XimbalEk-Electronica/CompVuelo/KiCad-Libraries/bordeplaca.dxf

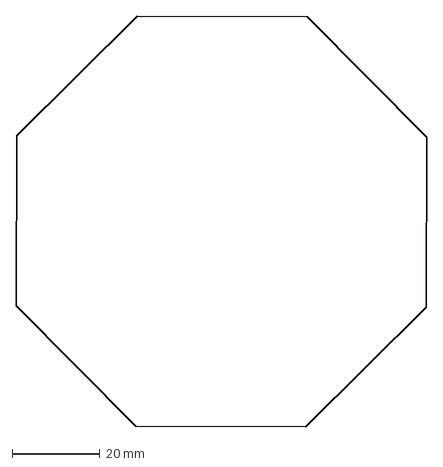
[picture p1: CAD file, 2025-10-03]
KiCad-Libraries/bordeplaca.dxf
93.3 x 93.3 mm
