XimbalEk-Electronica/CompVuelo/KiCad-Libraries/CompVuelo_3D/LCC-18_9P7X10P1_STM.step

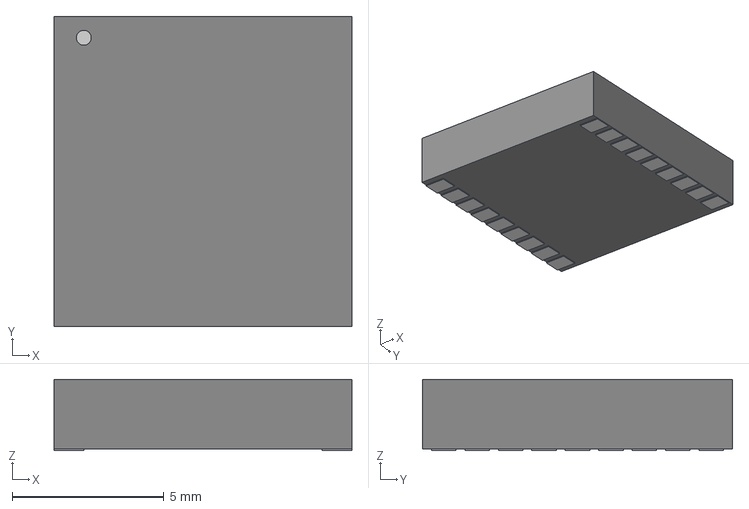
[picture p2: CAD file, 2025-10-03]
KiCad-Libraries/CompVuelo_3D/LCC-18_9P7X10P1_STM.step
9.80 x 10.2 x 2.34 mm
