XimbalEk-Electronica/CompVuelo/KiCad-Libraries/CompVuelo_3D/ESP32-S3-MINI-1U-N8--3DModel-STEP-56544.STEP

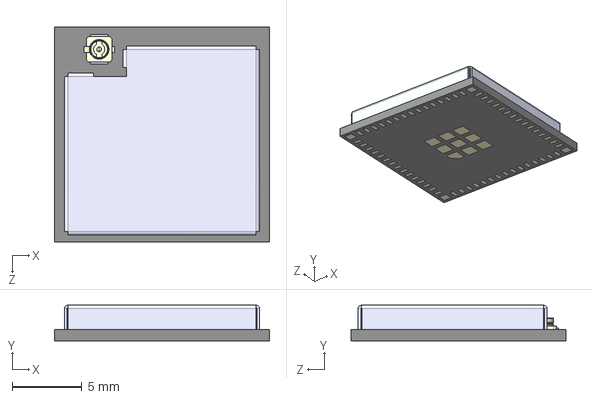
[picture p3: CAD file, 2025-10-03]
KiCad-Libraries/CompVuelo_3D/ESP32-S3-MINI-1U-N8--3DModel-STEP-56544.STEP
15.4 x 2.55 x 15.4 mm
ESP32-S3-MINI-1U-N8_ESP32-C3-MINI-1-N4
antenna jack
