XimbalEk-Electronica/CompVuelo/KiCad-Libraries/CompVuelo_3D/E22-400M22S.STEP

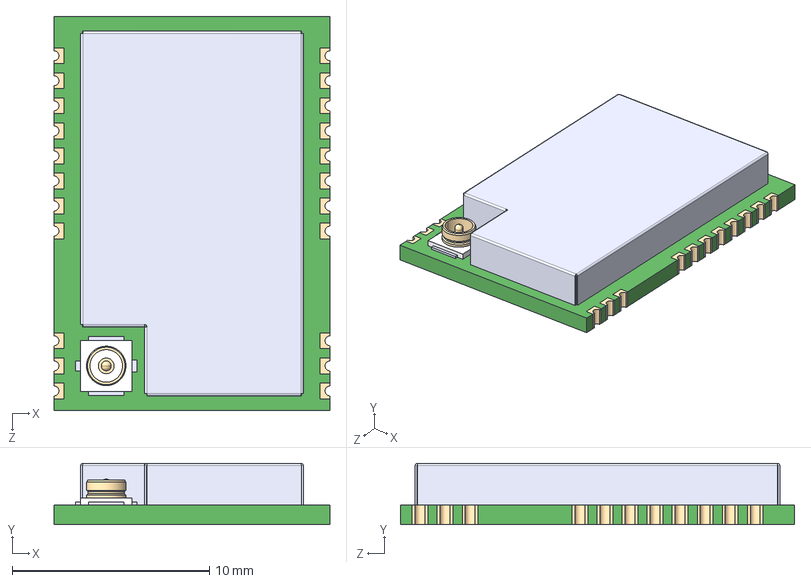
[picture p4: CAD file, 2025-10-03]
KiCad-Libraries/CompVuelo_3D/E22-400M22S.STEP
14.0 x 3.10 x 20.0 mm
