XimbalEk-Electronica/CompVuelo/KiCad-Libraries/CompVuelo_3D/LIS2MDLTR.step

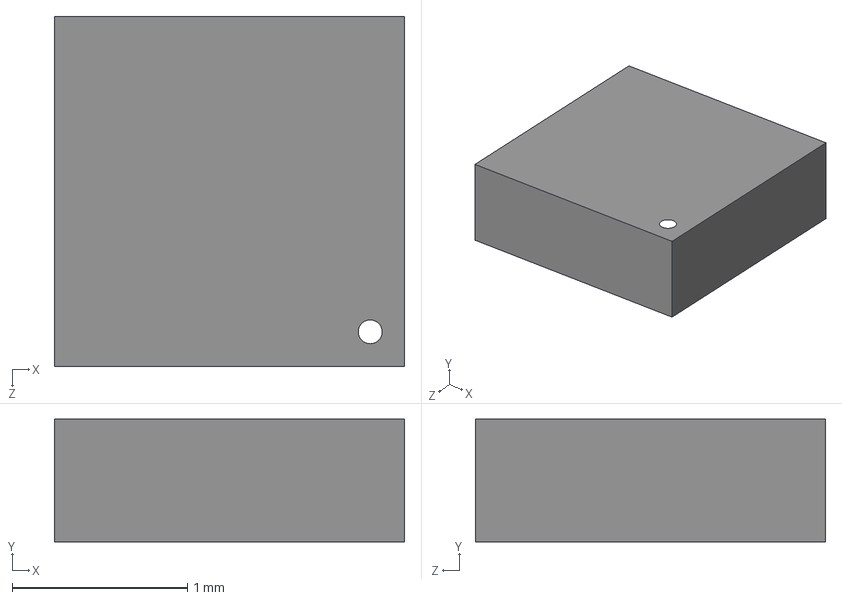
[picture p5: CAD file, 2025-10-03]
KiCad-Libraries/CompVuelo_3D/LIS2MDLTR.step
2.00 x 0.7 x 2.00 mm
