XimbalEk-Electronica/CompVuelo/KiCad-Libraries/CompVuelo_3D/XT60-M.step

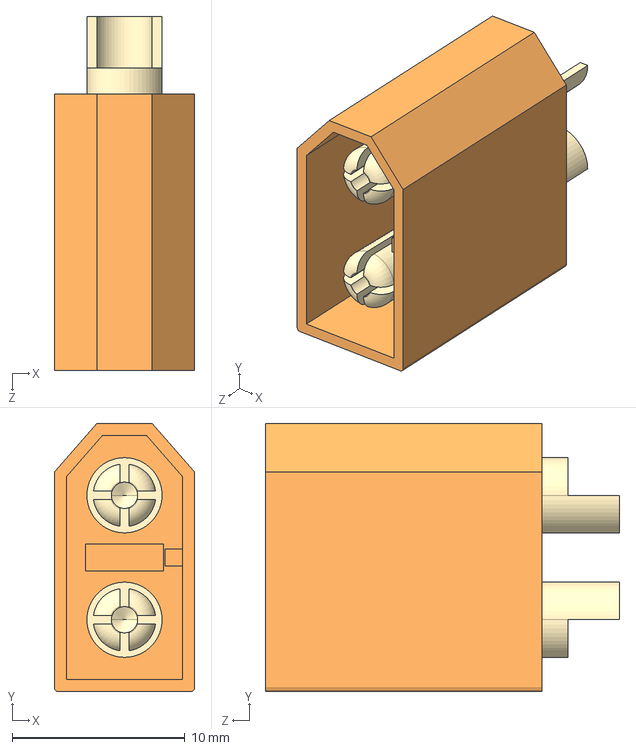
[picture p6: CAD file, 2025-10-03]
KiCad-Libraries/CompVuelo_3D/XT60-M.step
8.10 x 15.5 x 20.5 mm
