XimbalEk-Electronica/CompVuelo/KiCad-Libraries/CompVuelo_3D/BMP390L.step

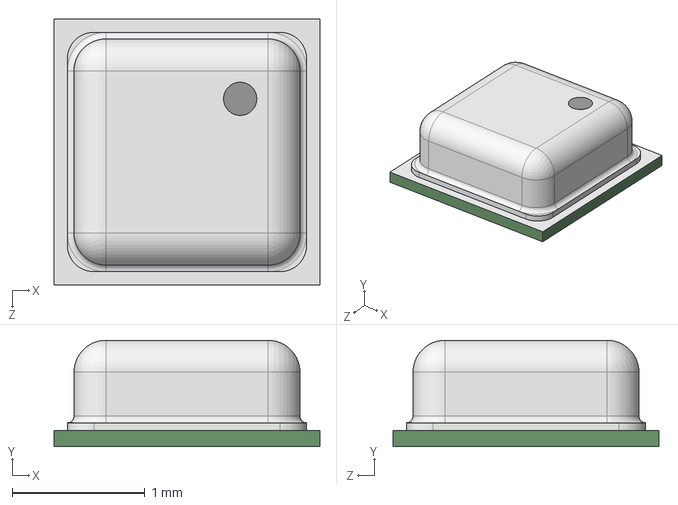
[picture p7: CAD file, 2025-09-26]
KiCad-Libraries/CompVuelo_3D/BMP390L.step
2.00 x 0.8 x 2.00 mm
