XimbalEk-Electronica/CompVuelo/KiCad-Libraries/CompVuelo_3D/BMI270.step

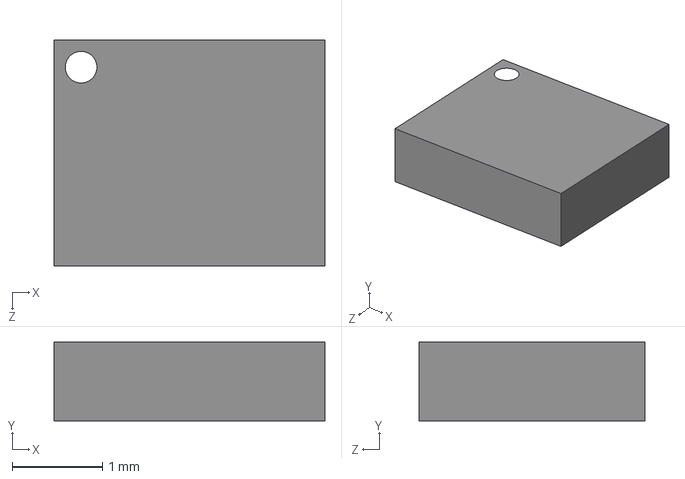
[picture p8: CAD file, 2025-09-26]
KiCad-Libraries/CompVuelo_3D/BMI270.step
3.00 x 0.87 x 2.50 mm
