XimbalEk-Electronica/CompVuelo/KiCad-Libraries/CompVuelo_3D/Pin Header 2x6 TH Pitch 2.54mm.stp

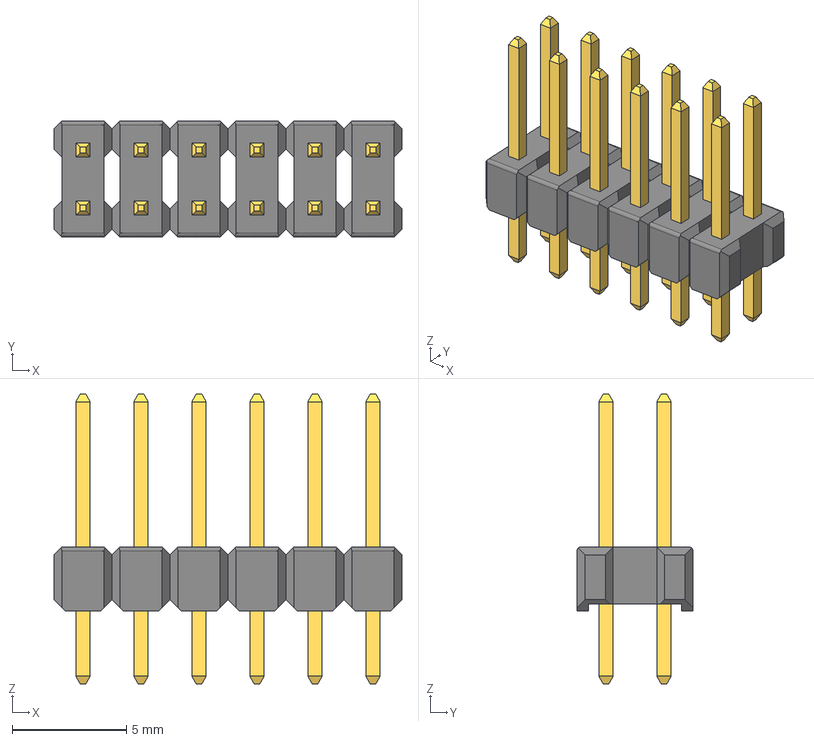
[picture p9: CAD file, 2025-09-23]
KiCad-Libraries/CompVuelo_3D/Pin Header 2x6 TH Pitch 2.54mm.stp
15.2 x 5.08 x 12.7 mm
