XimbalEk-Electronica/CompVuelo/KiCad-Libraries/CompVuelo_3D/VSSOP-8_3.0x3.0mm_P0.65mm.step

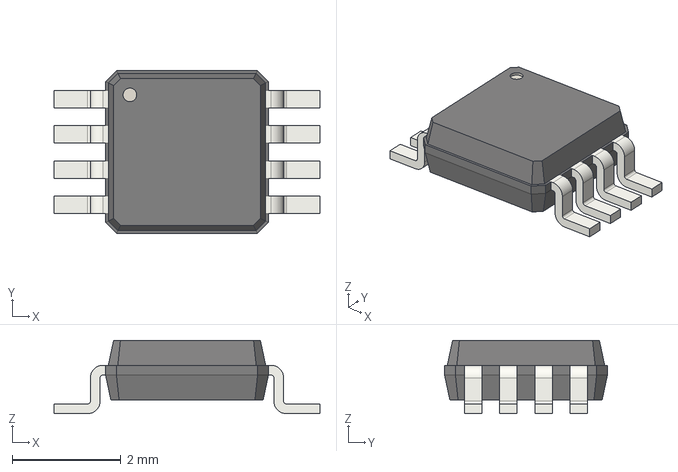
[picture p10: CAD file, 2025-09-23]
KiCad-Libraries/CompVuelo_3D/VSSOP-8_3.0x3.0mm_P0.65mm.step
4.90 x 3.00 x 1.35 mm
