XimbalEk-Electronica/CompVuelo/KiCad-Libraries/CompVuelo_3D/L-KLS7-SS-12F20A-G5.step

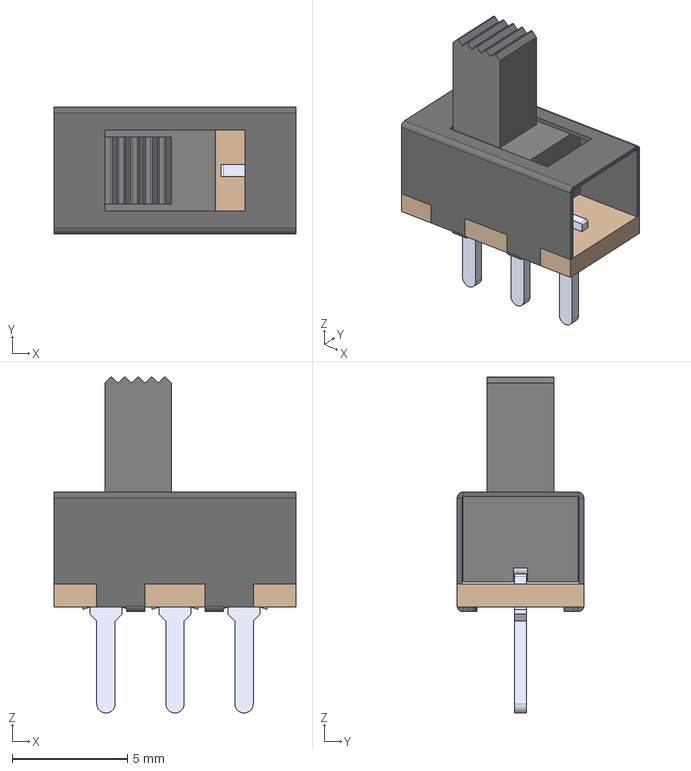
[picture p11: CAD file, 2025-09-23]
KiCad-Libraries/CompVuelo_3D/L-KLS7-SS-12F20A-G5.step
10.5 x 5.50 x 14.6 mm
