XimbalEk-Electronica/CompVuelo/KiCad-Libraries/CompVuelo_3D/12-Pin Header - Female - Double - 2.54mm.step

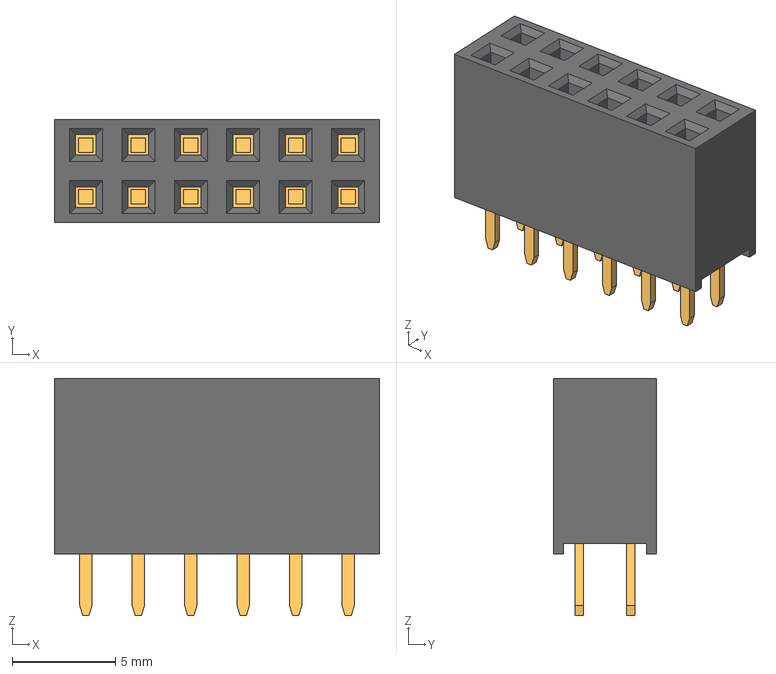
[picture p12: CAD file, 2025-09-23]
KiCad-Libraries/CompVuelo_3D/12-Pin Header - Female - Double - 2.54mm.step
15.7 x 5.00 x 11.5 mm
