XimbalEk-Electronica/CompVuelo/KiCad-Libraries/CompVuelo_3D/tact_switch_2.5mm.stp

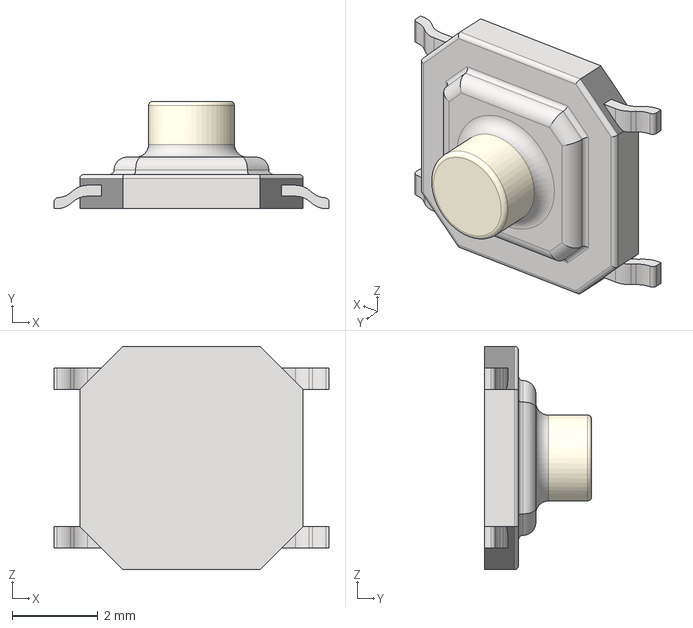
[picture p13: CAD file, 2025-09-23]
KiCad-Libraries/CompVuelo_3D/tact_switch_2.5mm.stp
6.40 x 2.50 x 5.20 mm
