XimbalEk-Electronica/CompVuelo/KiCad-Libraries/CompVuelo_3D/HTSOP-J8.STEP

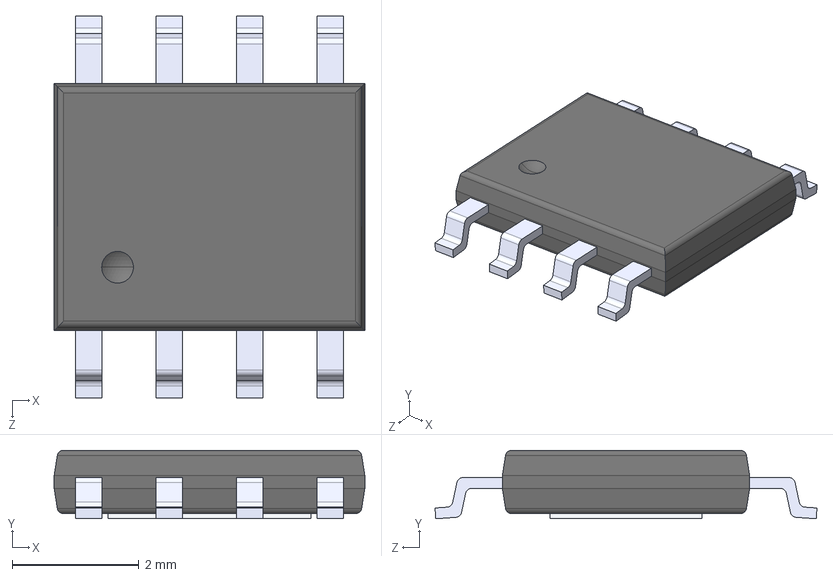
[picture p14: CAD file, 2025-09-10]
KiCad-Libraries/CompVuelo_3D/HTSOP-J8.STEP
4.90 x 1.08 x 6.02 mm
