XimbalEk-Electronica/CompVuelo/KiCad-Libraries/CompVuelo_3D/0472192001.stp

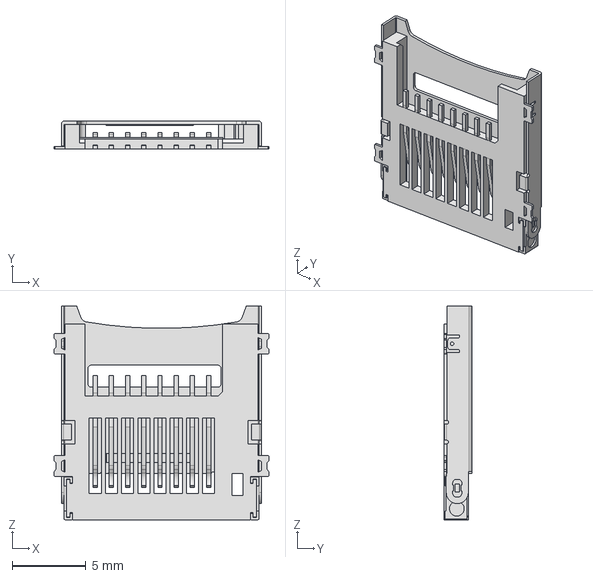
[picture p15: CAD file, 2025-10-03]
KiCad-Libraries/CompVuelo_3D/0472192001.stp
14.6 x 1.90 x 14.5 mm
