XimbalEk-Electronica/CompVuelo/KiCad-Libraries/CompVuelo_3D/LD39200DPUR.step

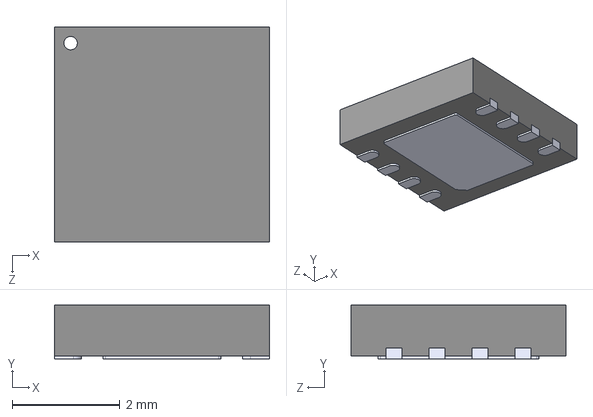
[picture p16: CAD file, 2025-09-10]
KiCad-Libraries/CompVuelo_3D/LD39200DPUR.step
4.00 x 1.00 x 4.00 mm
