XimbalEk-Electronica/CompVuelo/Communication&SensorBoard/Esquematicos/C&SBoard.pdf

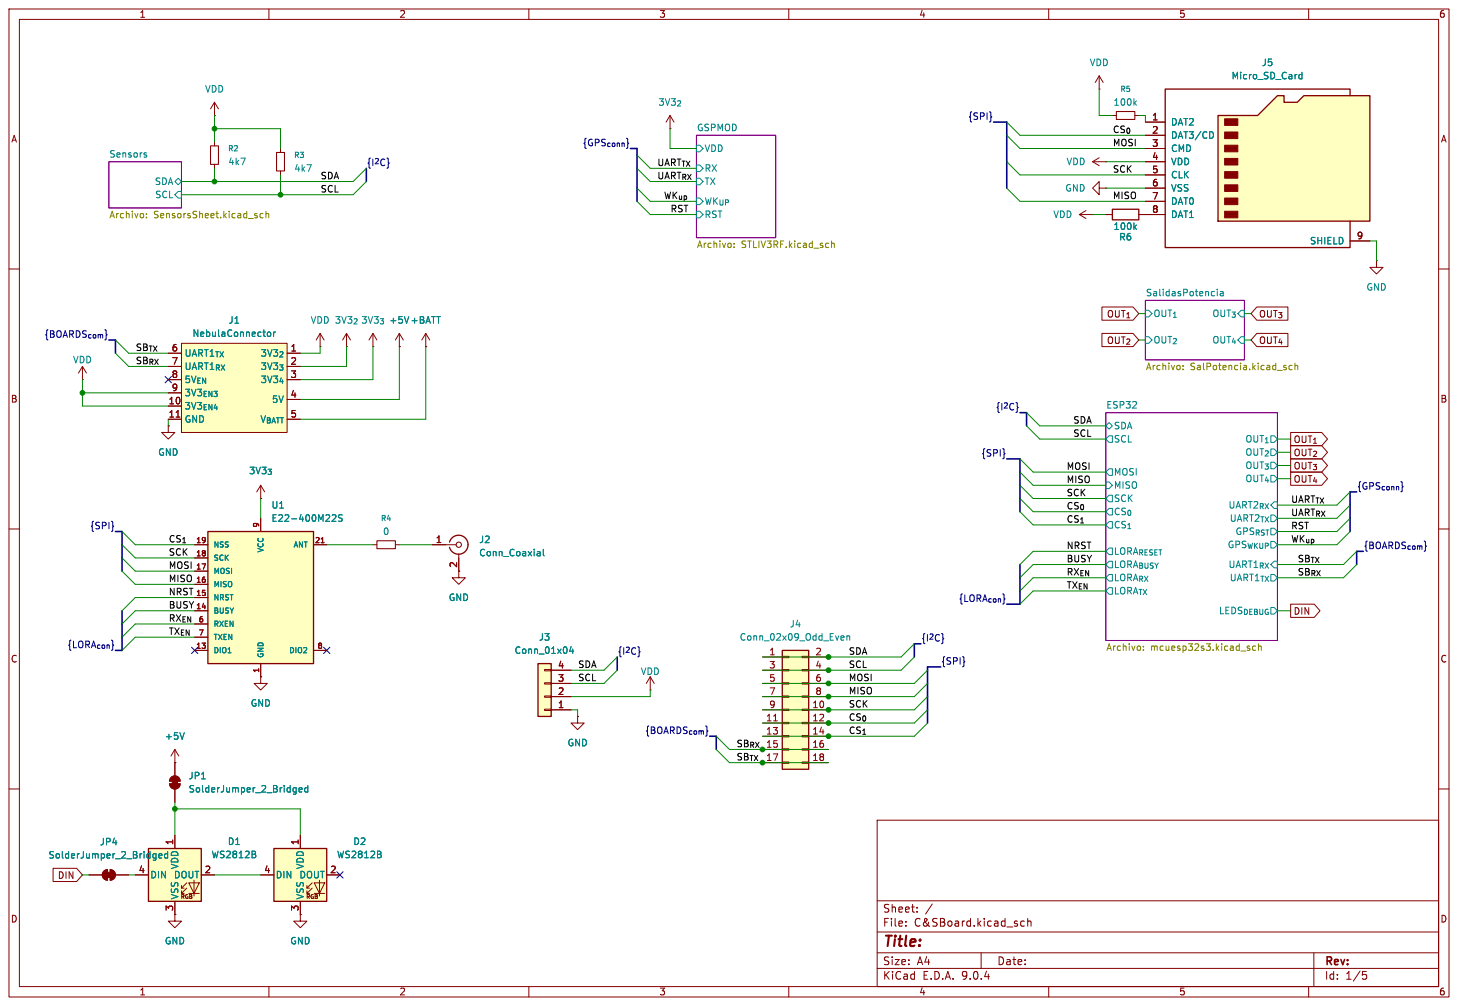
[picture p17: page 1]

OUT_{4} SalidasPotencia Archivo: SalPotencia.kicad_sch SCL SDA

BUSY CS_{1} SCK MOSI {SPI}

Id: 1/5 Title: File: C&SBoard.kicad_sch Sheet: /

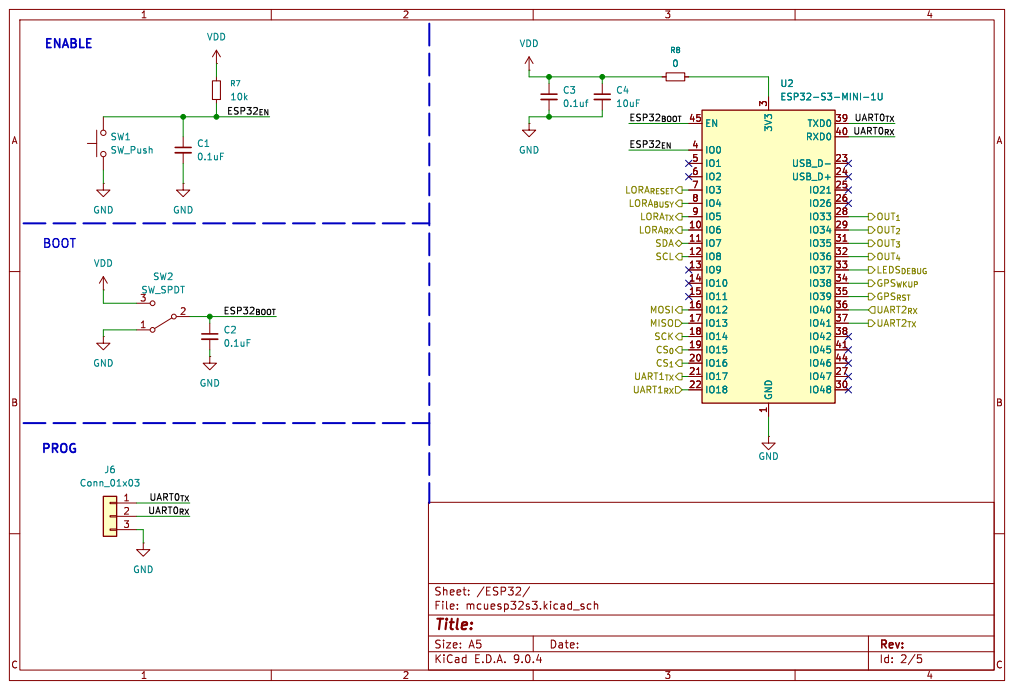
[picture p18: page 2]

Id: 2/5 Title: File: mcuesp32s3.kicad_sch Sheet: /ESP32/

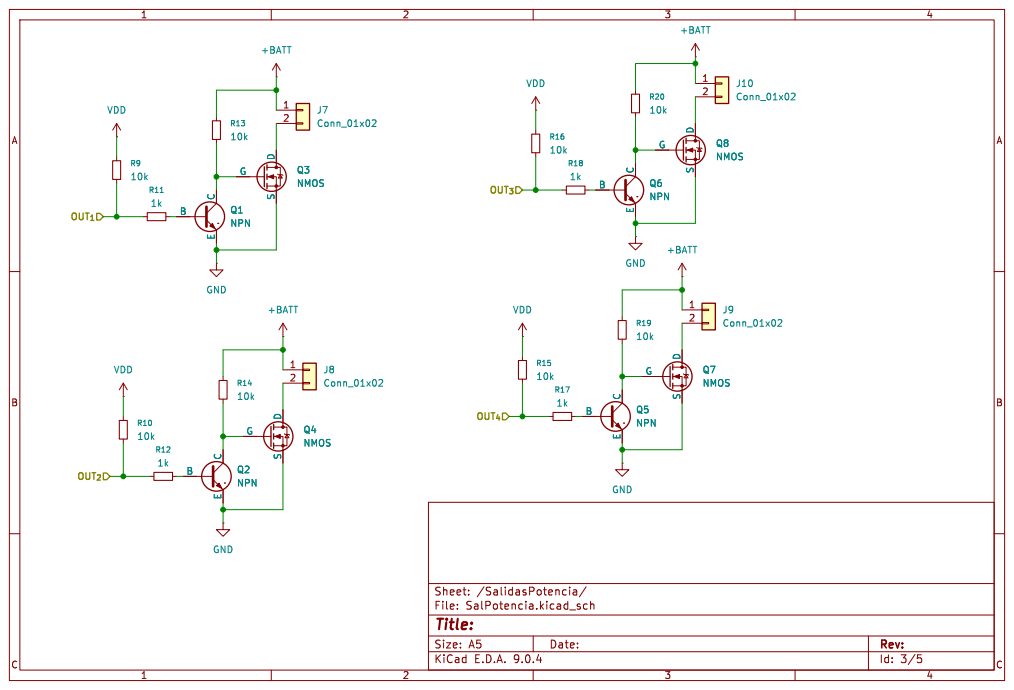
[picture p19: page 3]

Id: 3/5 Title: File: SalPotencia.kicad_sch Sheet: /SalidasPotencia/

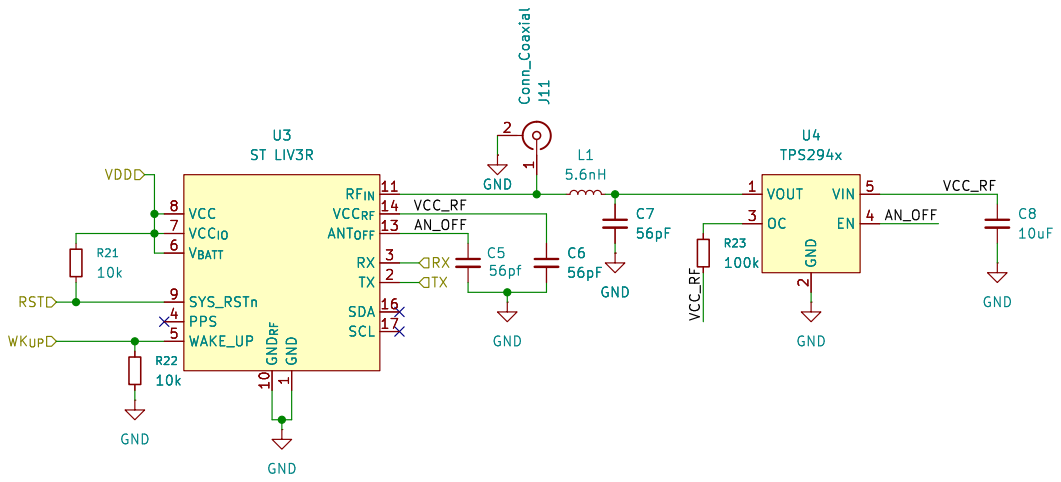
[picture p20: page 4]

1 RF_{IN} 11 VCC_{RF} 14 ANT_{OFF} 13 RX 3 TX 2 SDA 16 SCL 17 U3 ST LIV3R

1 RF_{IN} 11 VCC_{RF} 14 ANT_{OFF} 13 RX 3 TX 2 SDA 16 SCL 17 R22 10k GND

Id: 4/5 Title: File: STLIV3RF.kicad_sch Sheet: /GSPMOD/

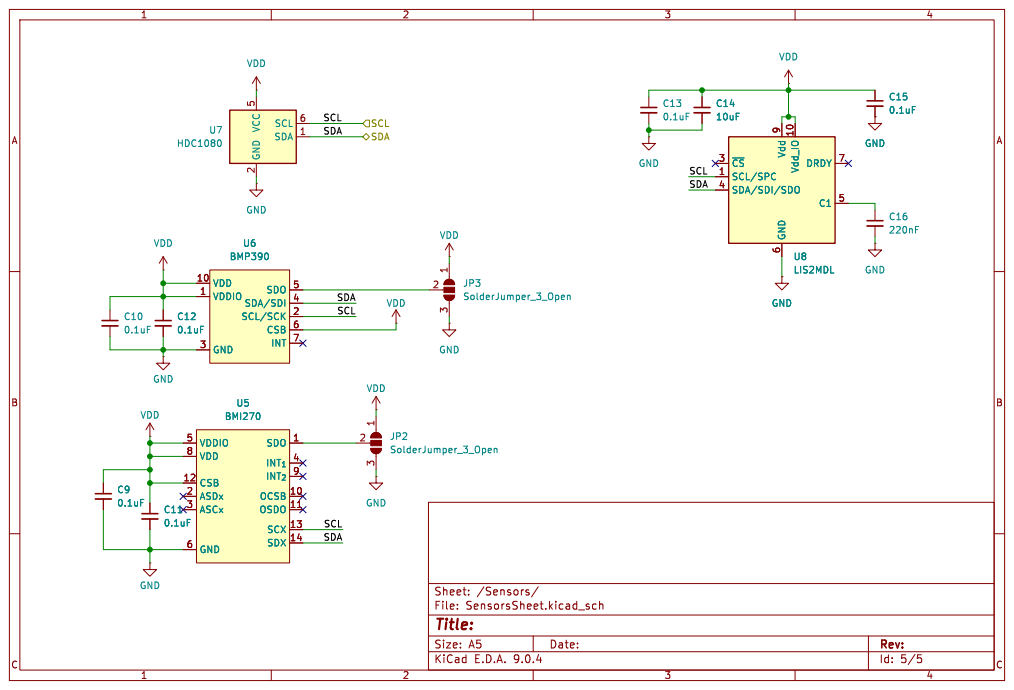
[picture p21: page 5]

Id: 5/5 Title: File: SensorsSheet.kicad_sch Sheet: /Sensors/
