XimbalEk-Electronica/CompVuelo/SupplyBoard/Esquematicos/SupplyBoardCompVuelo.pdf

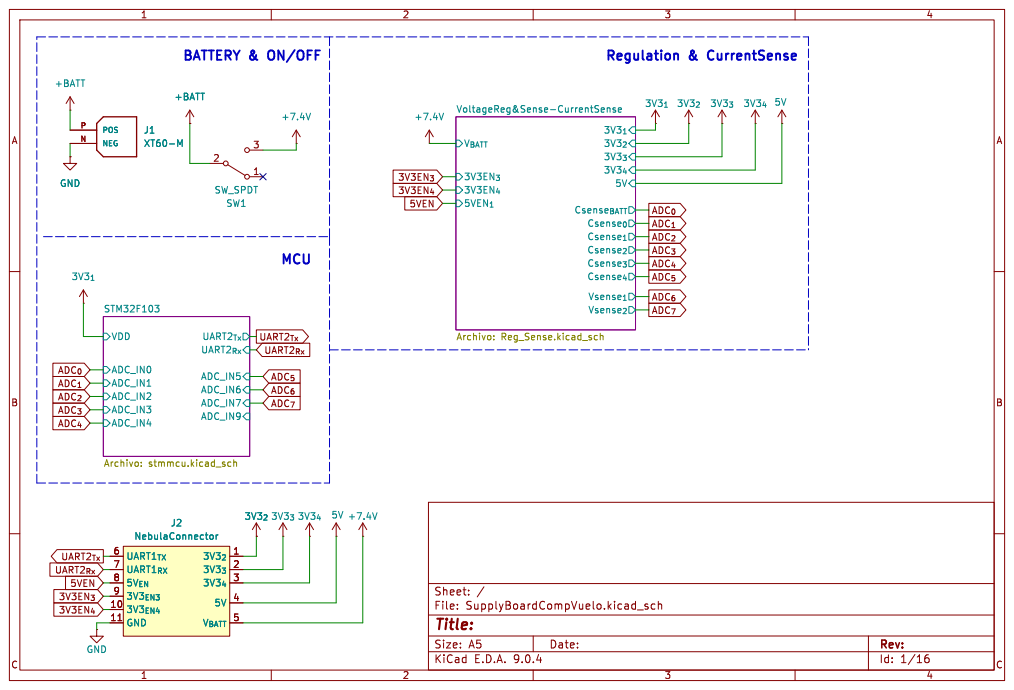
[picture p22: page 1]

Id: 1/16 Title: File: SupplyBoardCompVuelo.kicad_sch Sheet: /

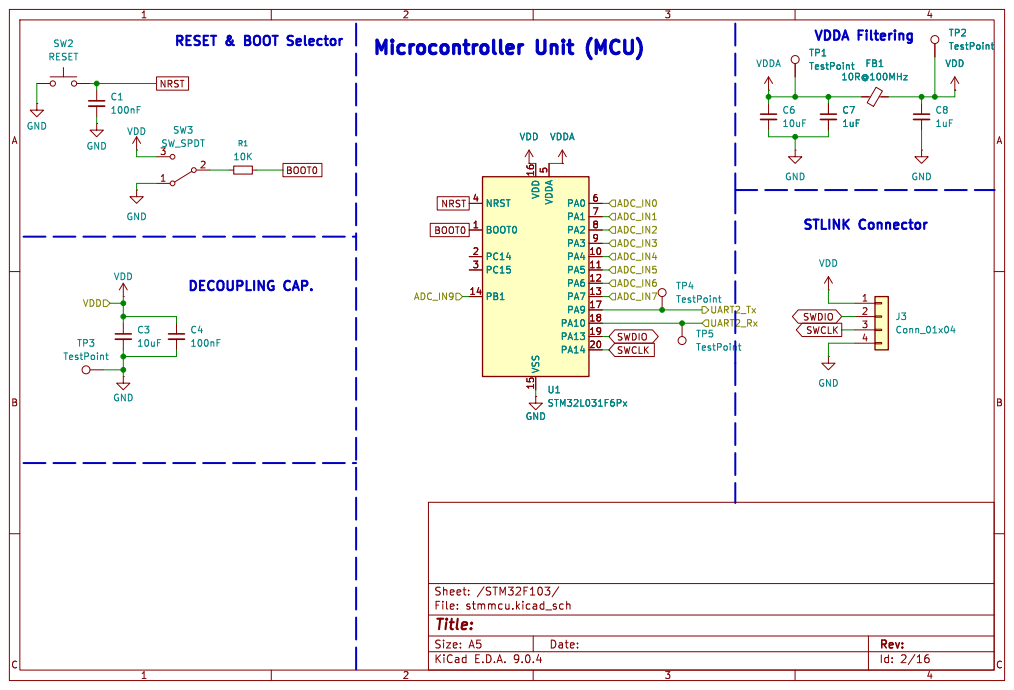
[picture p23: page 2]

TP2 TestPoint TP1 TestPoint VDD VDDA

Id: 2/16 Title: File: stmmcu.kicad_sch Sheet: /STM32F103/

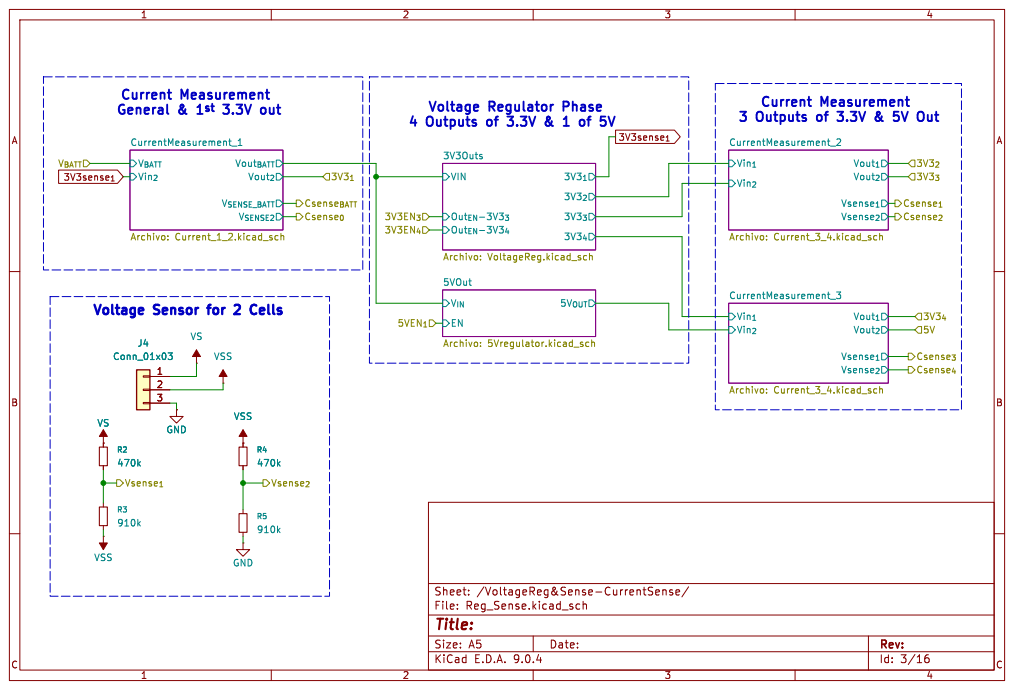
[picture p24: page 3]

Voltage Sensor for 2 Cells

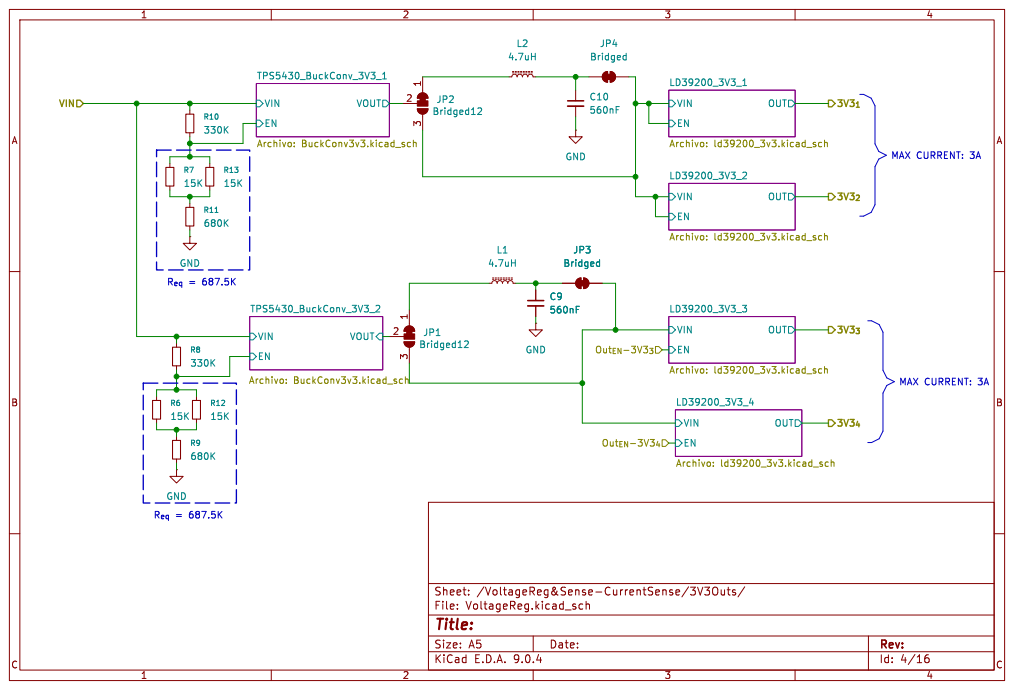
[picture p25: page 4]

Id: 4/16 Title: File: VoltageReg.kicad_sch Sheet: /VoltageReg&Sense-CurrentSense/3V3Outs/ EN

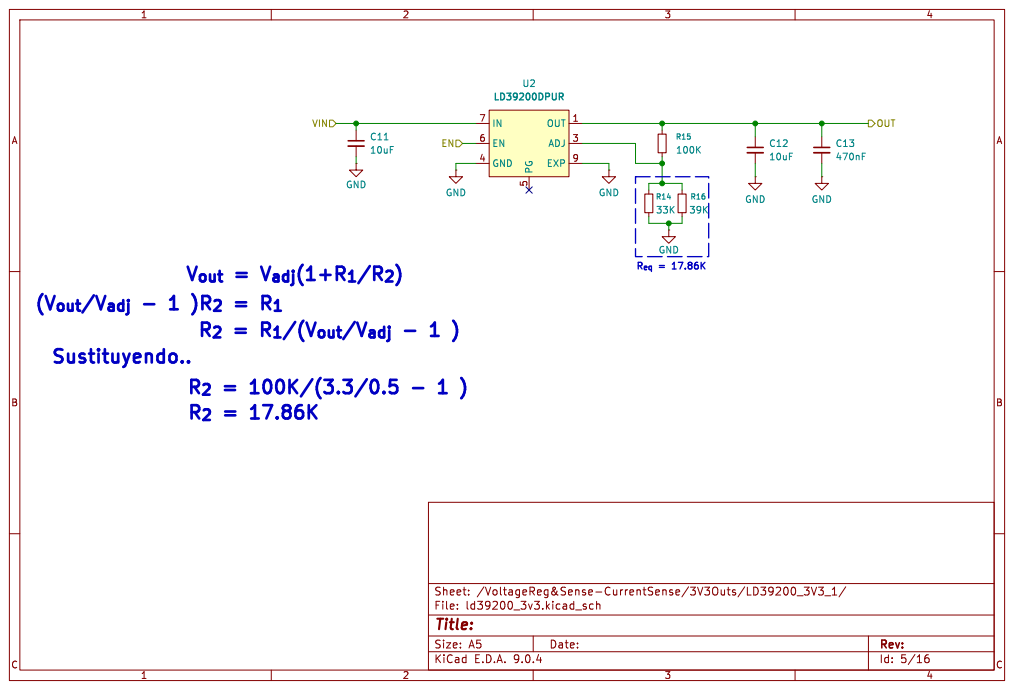
[picture p26: page 5]

5 OUT 1 ADJ 3 EXP 9 U2 LD39200DPUR GND GND

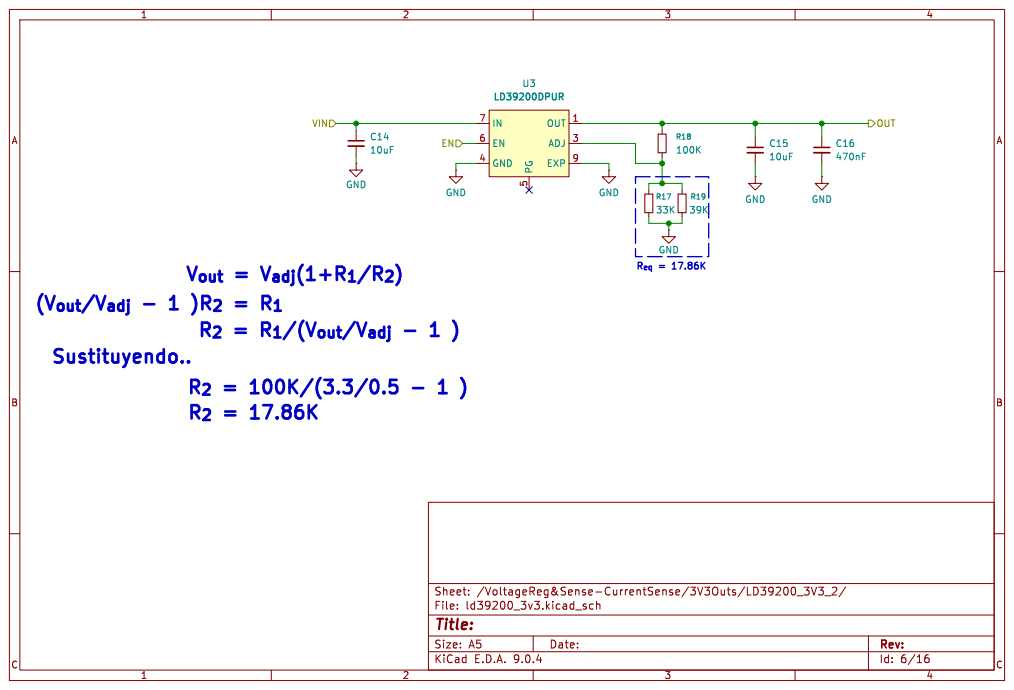
[picture p27: page 6]

5 OUT 1 ADJ 3 EXP 9 U3 LD39200DPUR GND GND

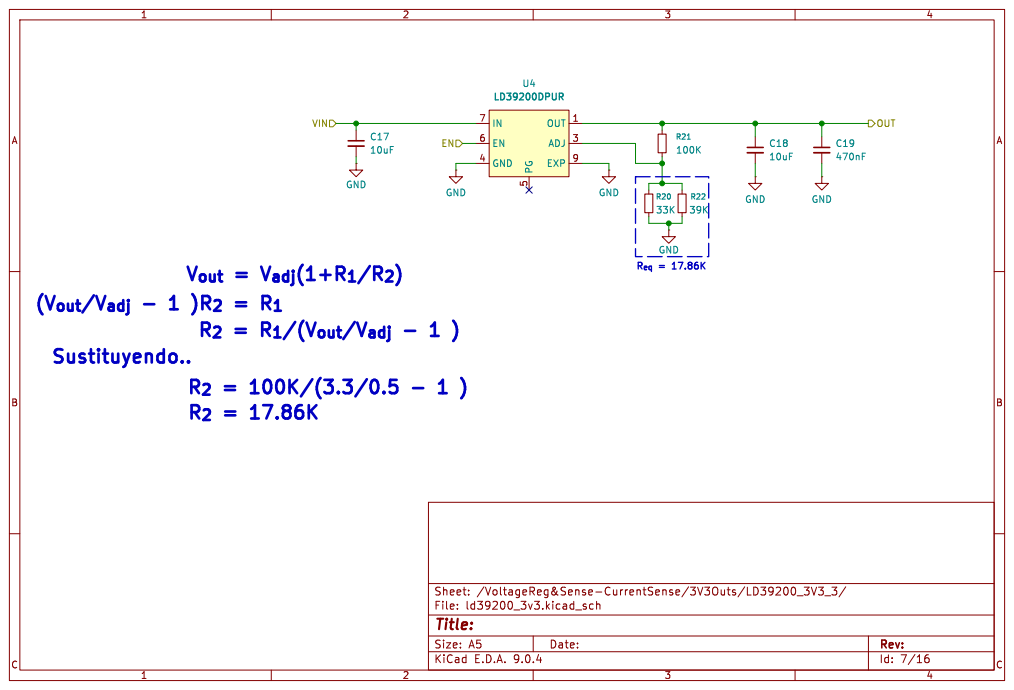
[picture p28: page 7]

5 OUT 1 ADJ 3 EXP 9 U4 LD39200DPUR GND GND

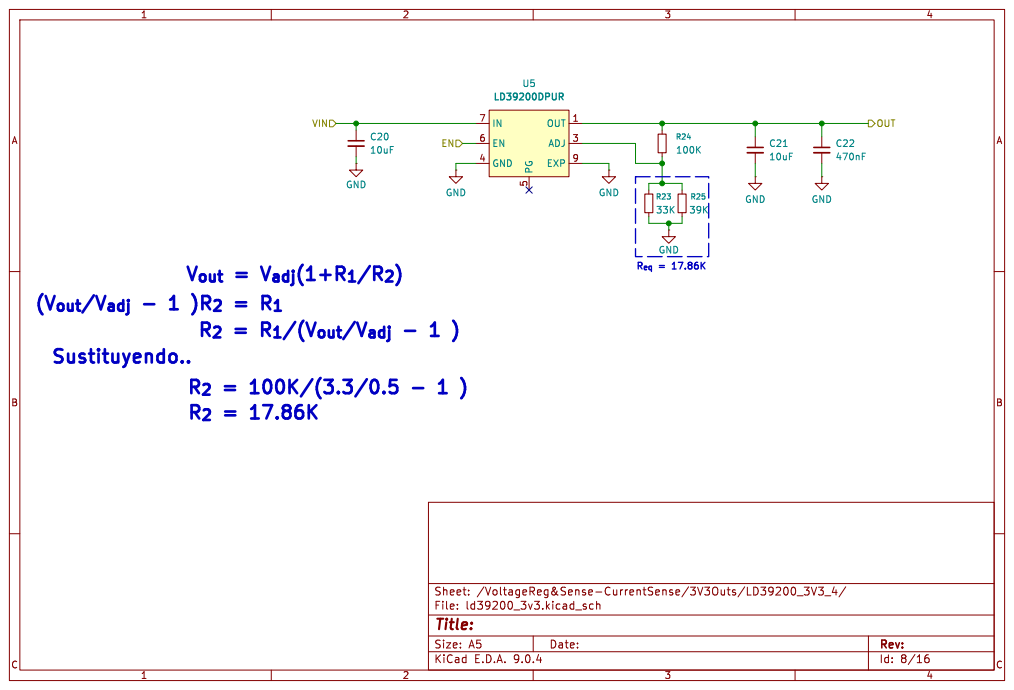
[picture p29: page 8]

5 OUT 1 ADJ 3 EXP 9 U5 LD39200DPUR GND GND

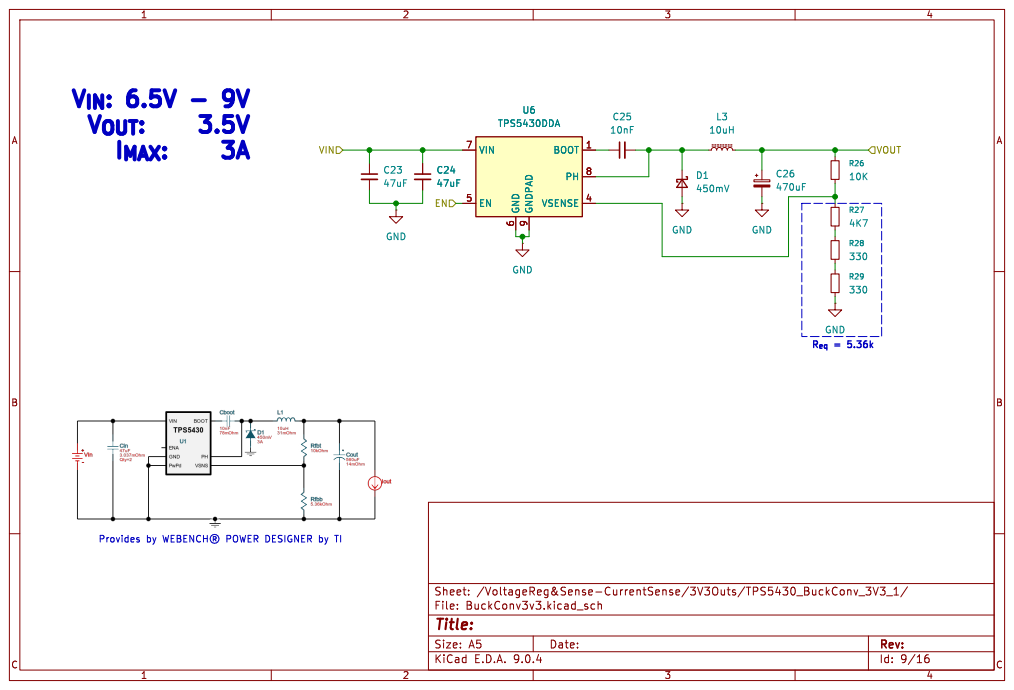
[picture p30: page 9]

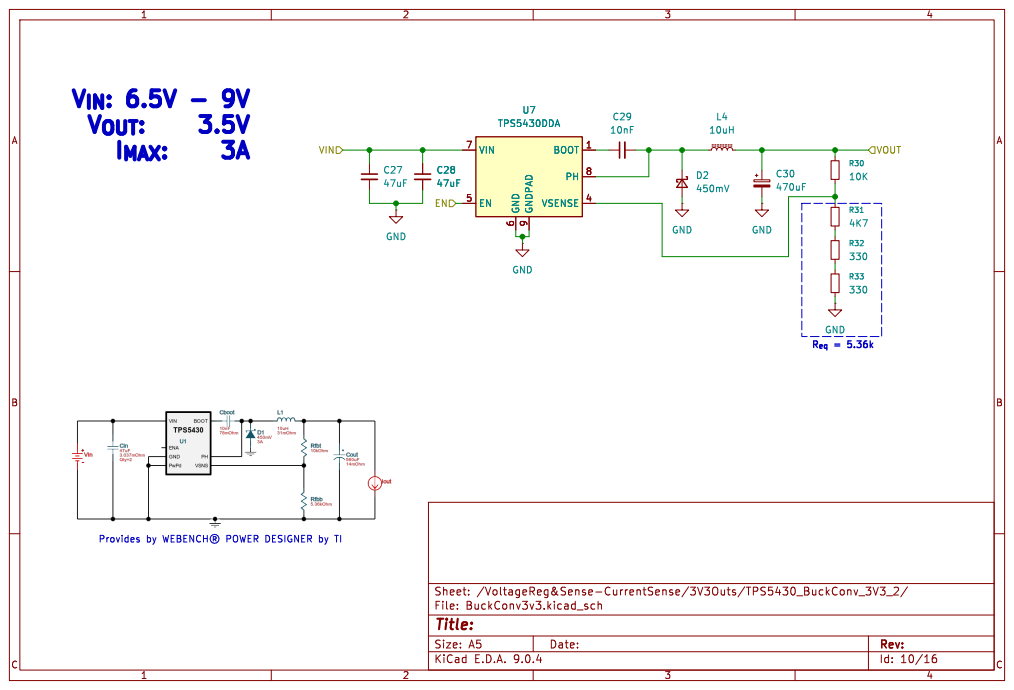
[picture p31: page 10]

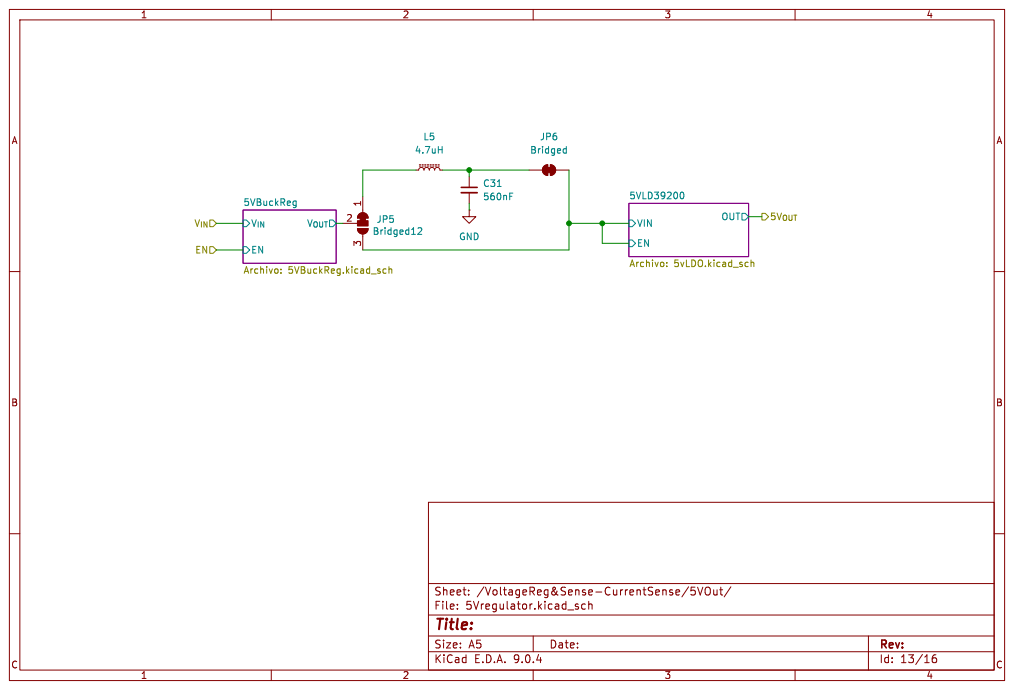
[picture p32: page 11]

Id: 13/16 Title: File: 5Vregulator.kicad_sch Sheet: /VoltageReg&Sense-CurrentSense/5VOut/ EN

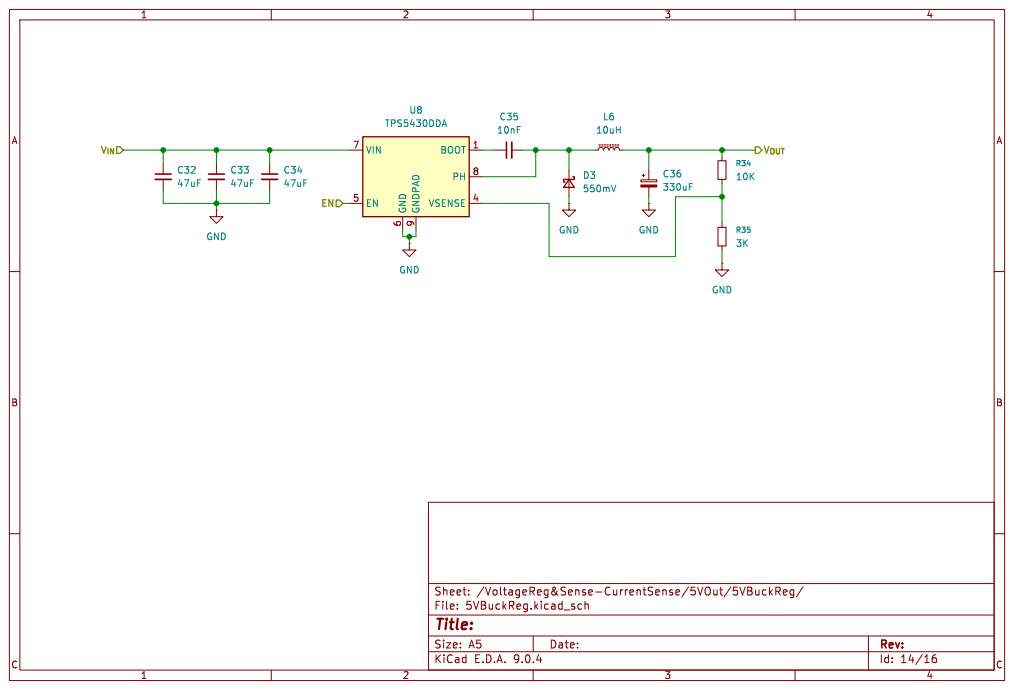
[picture p33: page 12]

Id: 14/16 Title: File: 5VBuckReg.kicad_sch Sheet: /VoltageReg&Sense-CurrentSense/5VOut/5VBuckReg/ GND

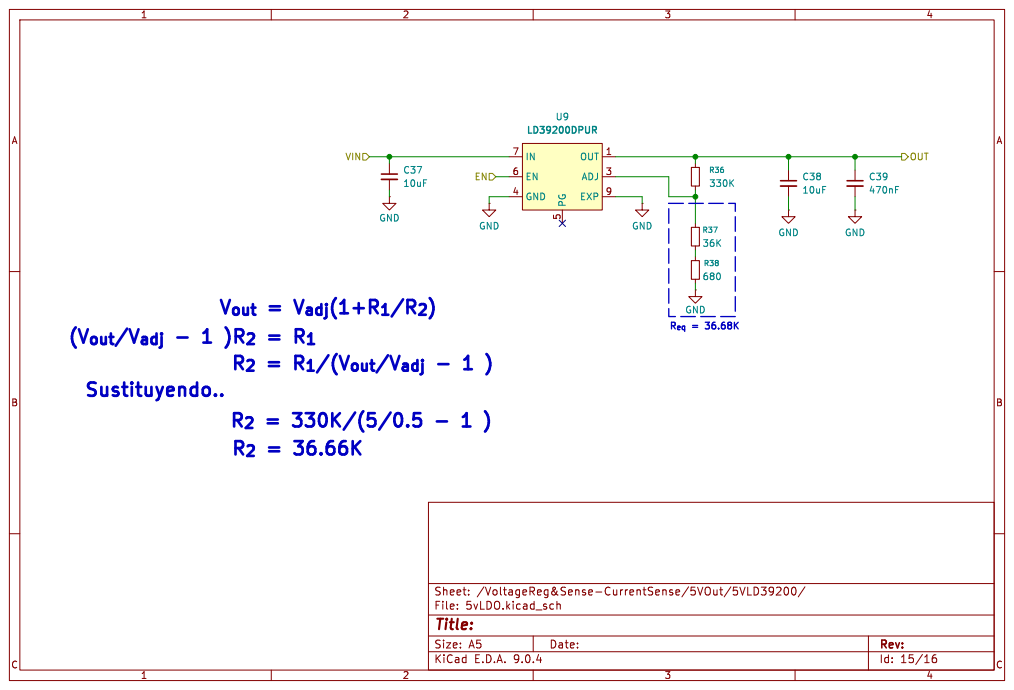
[picture p34: page 13]

5 OUT 1 ADJ 3 EXP 9 U9 LD39200DPUR GND

Id: 15/16 Title: File: 5vLDO.kicad_sch Sheet: /VoltageReg&Sense-CurrentSense/5VOut/5VLD39200/

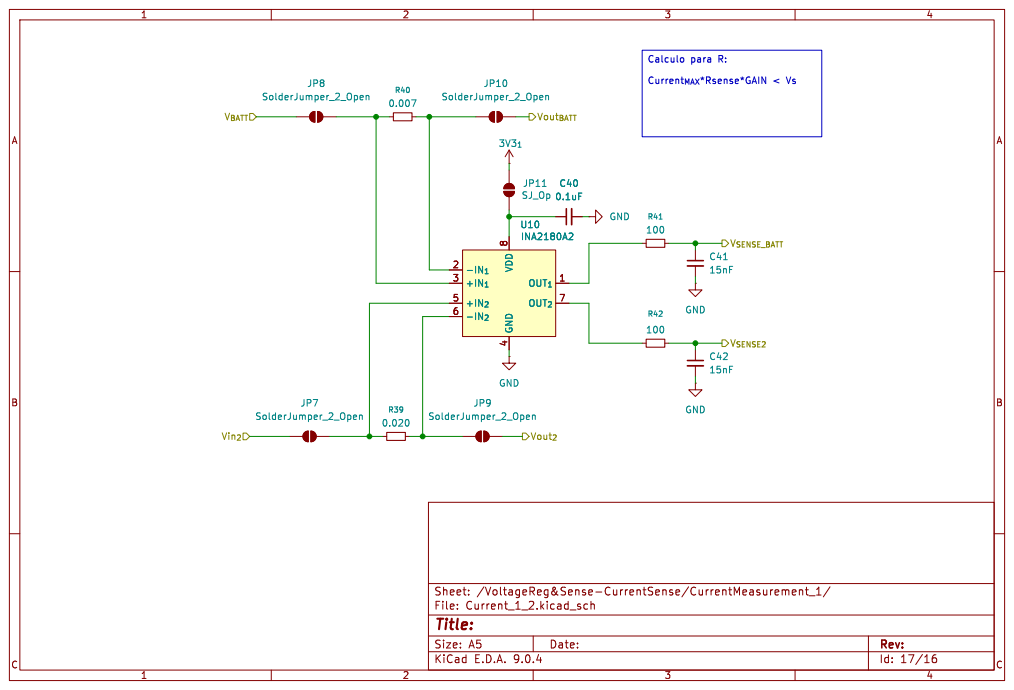
[picture p35: page 14]

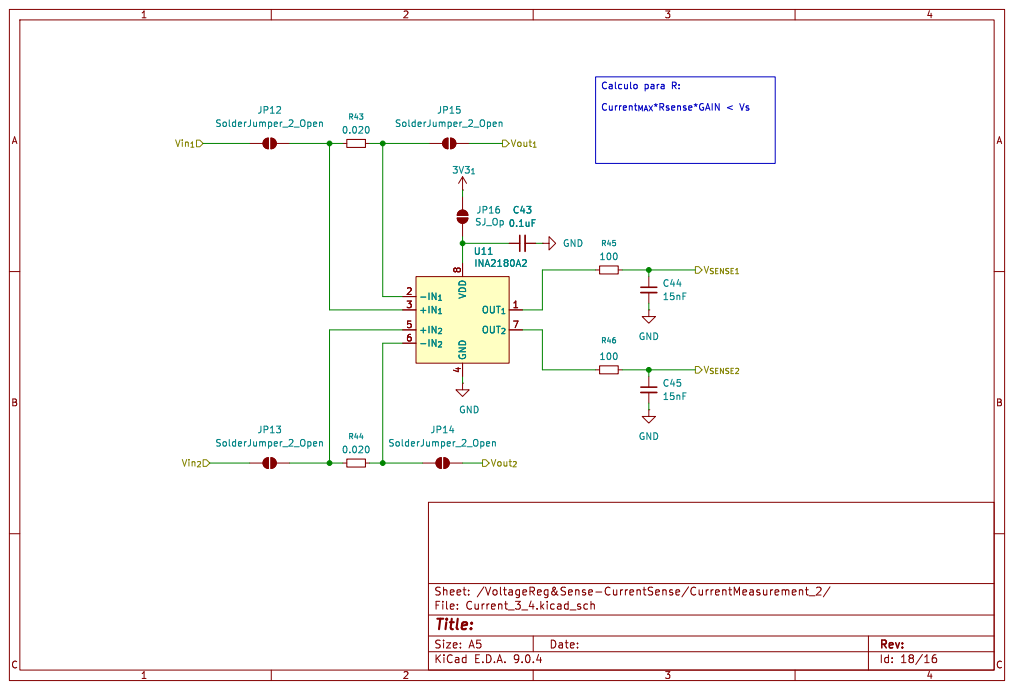
[picture p36: page 15]

V_{SENSE2} Calculo para R: Current_{MAX}*Rsense*GAIN < Vs C43

Id: 18/16 Title: File: Current_3_4.kicad_sch Sheet: /VoltageReg&Sense-CurrentSense/CurrentMeasurement_2/

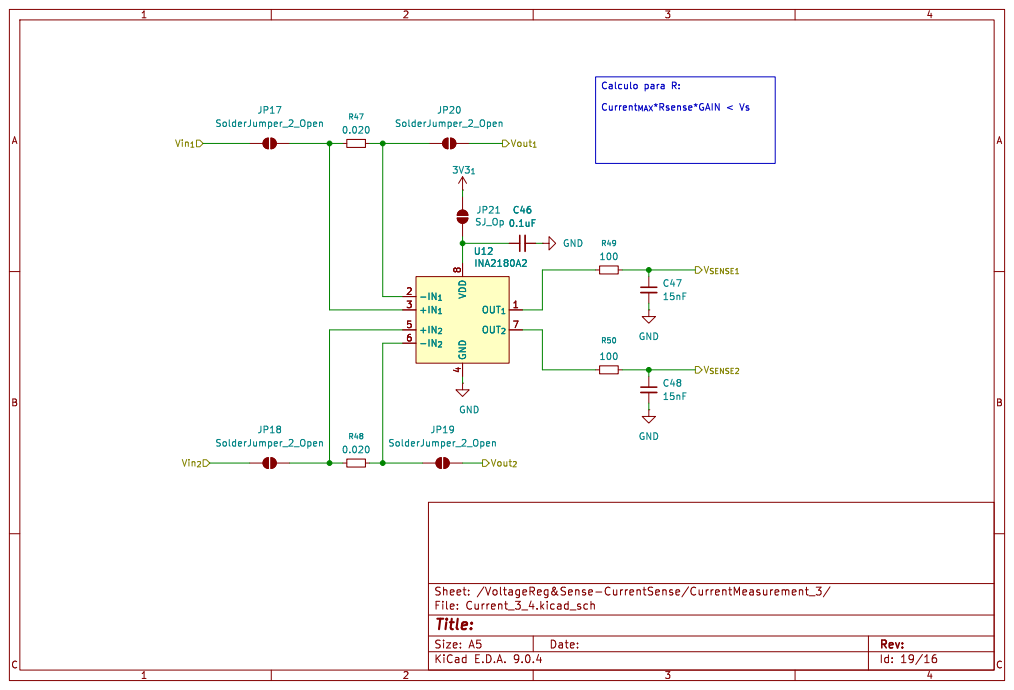
[picture p37: page 16]

V_{SENSE2} Calculo para R: Current_{MAX}*Rsense*GAIN < Vs C46
0.1uF GND

Id: 19/16 Title: File: Current_3_4.kicad_sch Sheet: /VoltageReg&Sense-CurrentSense/CurrentMeasurement_3/
