XimbalEk-Electronica/CompVuelo/OldCompVuelo/SupplyBoard/PCB/SupplyBoardCompVuelo.kicad_pcb

## KiCad design OldCompVuelo/SupplyBoard/PCB/SupplyBoardCompVuelo.kicad_pcb (2025-10-03, an earlier design)

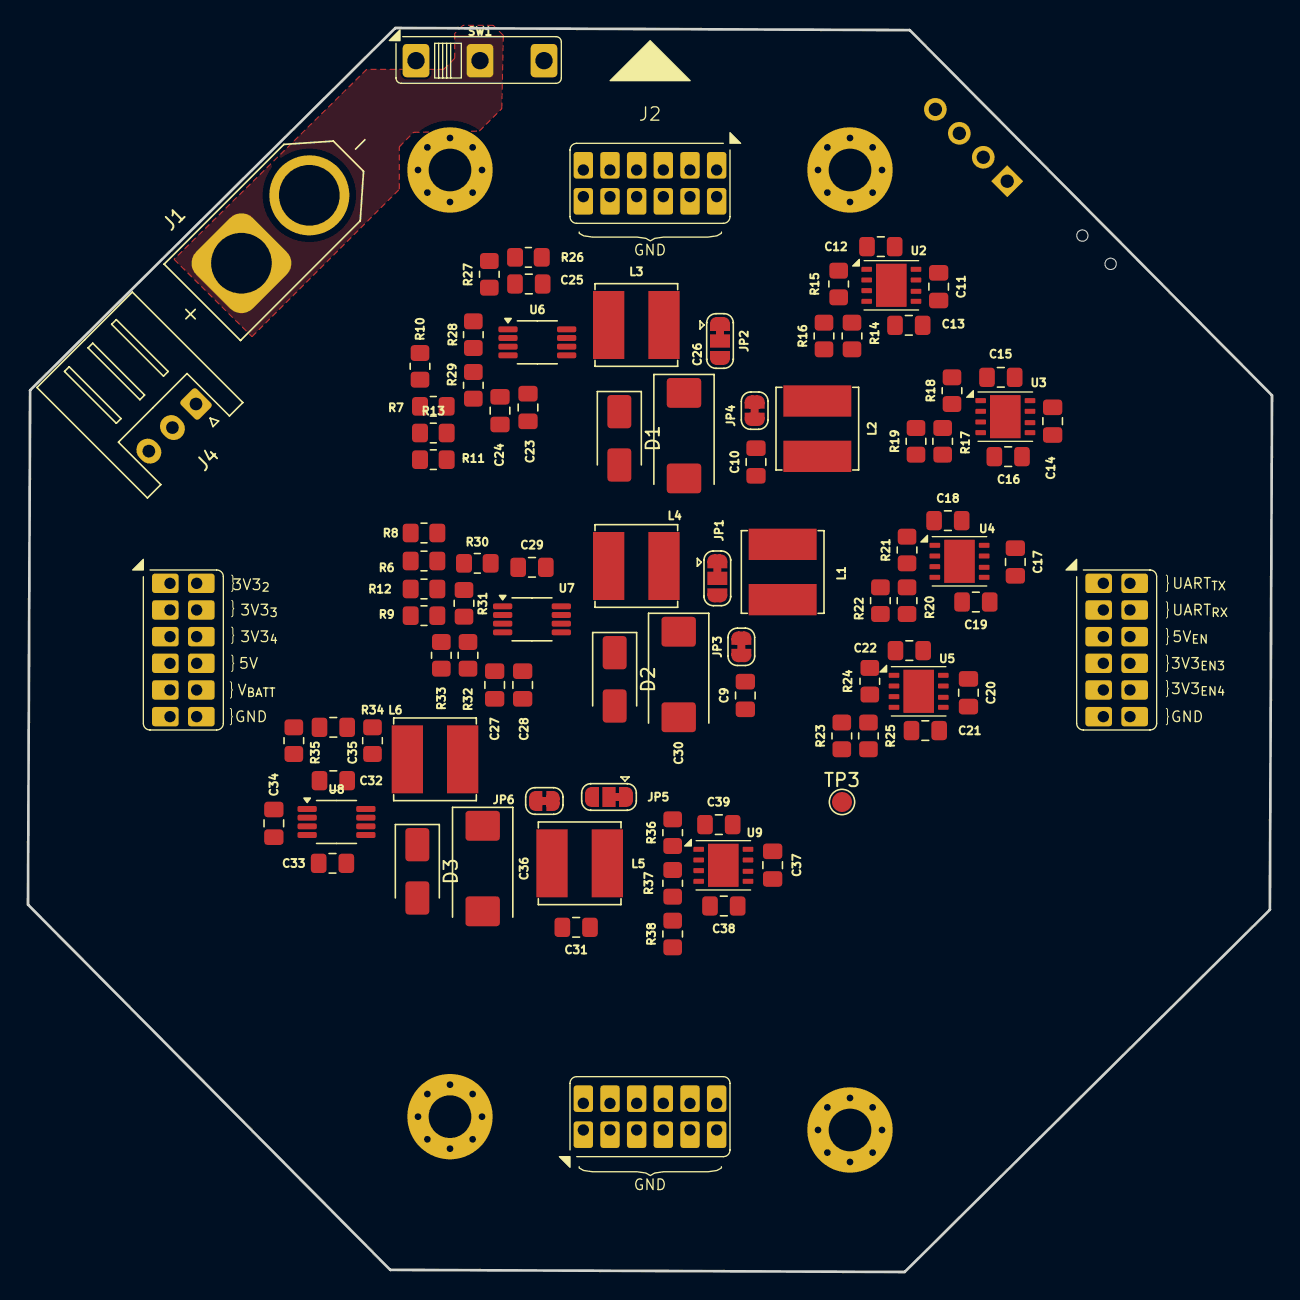
[picture p38: board SupplyBoardCompVuelo.kicad_pcb from above]

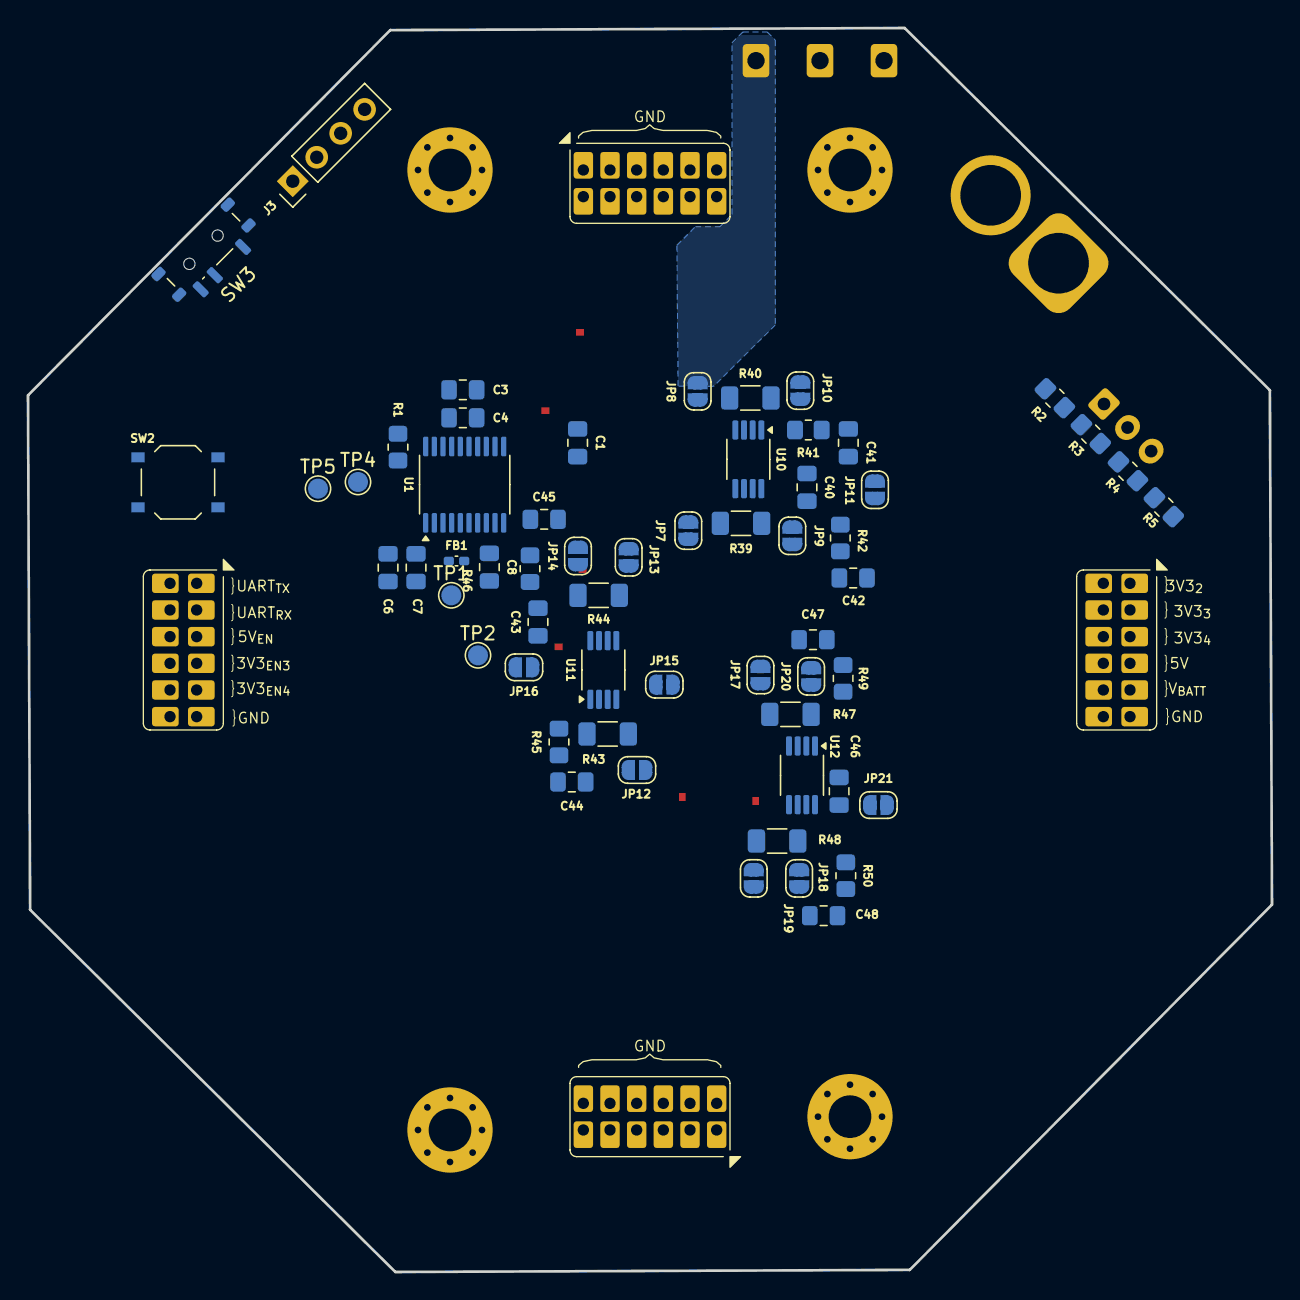
[picture p39: board SupplyBoardCompVuelo.kicad_pcb from below]

Board: 2 copper layers, 93.3 x 93.3 mm, 151 parts (59 on the bottom side), 91 nets, no tracks yet.

Parts:
C1, C4: 100nF; C_0805_2012Metric_Pad1.18x1.45mm_HandSolder
C3, C6, C11, C12, C14, C15, C17, C18, C20, C21, C37, C38: 10uF; C_0805_2012Metric_Pad1.18x1.45mm_HandSolder
C7, C8: 1uF; C_0805_2012Metric_Pad1.18x1.45mm_HandSolder
C9, C10, C31: 560nF; C_0805_2012Metric_Pad1.18x1.45mm_HandSolder
C13, C16, C19, C22, C39: 470nF; C_0805_2012Metric_Pad1.18x1.45mm_HandSolder
C23, C24, C27, C28, C32, C33, C34: 47uF; C_0805_2012Metric_Pad1.18x1.45mm_HandSolder
C25, C29, C35: 10nF; C_0805_2012Metric_Pad1.18x1.45mm_HandSolder
C26, C30: 470uF; CP_EIA-7343-31_Kemet-D_HandSolder
C36: 330uF; CP_EIA-7343-31_Kemet-D_HandSolder
C40, C43, C46: 0.1uF; C_0805_2012Metric_Pad1.18x1.45mm_HandSolder
C41, C42, C44, C45, C47, C48: 15nF; C_0805_2012Metric_Pad1.18x1.45mm_HandSolder
D1, D2: 450mV; D_SMA
D3: 550mV; D_SMA
FB1: 10R@100MHz; L_0402_1005Metric_Pad0.77x0.64mm_HandSolder
J1: XT60-M; AMASS_XT60-M
J2: NebulaConnector; GeneralConn
J3: Conn_01x04; PinHeader_1x04_P2.54mm_Vertical
J4: Conn_01x03; JST_XH_S3B-XH-A_1x03_P2.50mm_Horizontal
JP1, JP2, JP5: Bridged12; SolderJumper-3_P1.3mm_Bridged12_RoundedPad1.0x1.5mm
JP3, JP4, JP6: Bridged; SolderJumper-2_P1.3mm_Bridged_RoundedPad1.0x1.5mm
JP7, JP8, JP9, JP10, JP12, JP13, JP14, JP15, JP17, JP18, JP19, JP20: SolderJumper_2_Open; SolderJumper-2_P1.3mm_Open_RoundedPad1.0x1.5mm
JP11, JP16, JP21: SJ_Op; SolderJumper-2_P1.3mm_Open_RoundedPad1.0x1.5mm
L1, L2, L5: 4.7uH; L_Bourns_SRN6045TA
L3, L4, L6: 10uH; L_Bourns_SRN6045TA
R1, R26, R30, R34: 10K; R_0805_2012Metric_Pad1.20x1.40mm_HandSolder
R2, R4: 470k; R_0805_2012Metric_Pad1.20x1.40mm_HandSolder
R3, R5: 910k; R_0805_2012Metric_Pad1.20x1.40mm_HandSolder
R6, R7, R12, R13: 15K; R_0805_2012Metric_Pad1.20x1.40mm_HandSolder
R8, R10, R36: 330K; R_0805_2012Metric_Pad1.20x1.40mm_HandSolder
R9, R11: 680K; R_0805_2012Metric_Pad1.20x1.40mm_HandSolder
R14, R17, R20, R23: 33K; R_0805_2012Metric_Pad1.20x1.40mm_HandSolder
R15, R18, R21, R24: 100K; R_0805_2012Metric_Pad1.20x1.40mm_HandSolder
R16, R19, R22, R25: 39K; R_0805_2012Metric_Pad1.20x1.40mm_HandSolder
R27, R31: 4K7; R_0805_2012Metric_Pad1.20x1.40mm_HandSolder
R28, R29, R32, R33: 330; R_0805_2012Metric_Pad1.20x1.40mm_HandSolder
R35: 3K; R_0805_2012Metric_Pad1.20x1.40mm_HandSolder
R37: 36K; R_0805_2012Metric_Pad1.20x1.40mm_HandSolder
R38: 680; R_0805_2012Metric_Pad1.20x1.40mm_HandSolder
R39, R43, R44, R47, R48: 0.020; R_1206_3216Metric_Pad1.30x1.75mm_HandSolder
R40: 0.007; R_1206_3216Metric_Pad1.30x1.75mm_HandSolder
R41, R42, R45, R46, R49, R50: 100; R_0805_2012Metric_Pad1.20x1.40mm_HandSolder
SW1: SW_SPDT; SWSPDT
SW2: RESET; SW_Push_1P1T_XKB_TS-1187A
SW3: SW_SPDT; SW_SPDT_Shouhan_MSK12C02
TP1, TP2, TP3, TP4, TP5: TestPoint; TestPoint_Pad_D1.5mm
U1: STM32L031F6Px; TSSOP-20_4.4x6.5mm_P0.65mm
U2, U3, U4, U5, U9: LD39200DPUR
U6, U7, U8: TPS5430DDA; Texas_S-PDSO-G8_3x3mm_P0.65mm
U10, U11, U12: INA2180A2; Texas_S-PDSO-G8_3x3mm_P0.65mm

Connections:
3V3EN_{3}: J2.9 (3V3_{EN3}), U4.6 (EN)
3V3EN_{4}: J2.10 (3V3_{EN4}), U5.6 (EN)
3V3_{1}: C3.1, C4.1, C8.1, FB1.2, J3.1, JP9.2 (B), JP11.2 (B), JP16.2 (B), JP21.2 (B), SW3.3, TP2.1, U1.16 (VDD)
3V3_{2}: J2.1 (3V3_{2}), JP15.2 (B)
3V3_{3}: J2.2 (3V3_{3}), JP14.2 (B)
3V3_{4}: J2.3 (3V3_{4}), JP20.2 (B)
3V3sense_{1}: C12.1, C13.1, JP7.1 (A), R15.1, U2.1 (OUT)
5V: J2.4 (5V), JP19.2 (B)
5VEN: J2.8 (5V_{EN}), U8.5 (EN)
+7.4V: J2.5 (V_{BATT}), JP8.1 (A), SW1.3
+BATT: J1.P (POS), SW1.2
/STM32F103/UART2_Rx: TP5.1, U1.18 (PA10)
/STM32F103/UART2_Tx: TP4.1, U1.17 (PA9)
/VoltageReg&Sense-CurrentSense/3V3Outs/3V3_{2}: C15.1, C16.1, JP12.1 (A), R18.1, U3.1 (OUT)
/VoltageReg&Sense-CurrentSense/3V3Outs/3V3_{3}: C18.1, C19.1, JP13.1 (A), R21.1, U4.1 (OUT)
/VoltageReg&Sense-CurrentSense/3V3Outs/3V3_{4}: C21.1, C22.1, JP17.1 (A), R24.1, U5.1 (OUT)
/VoltageReg&Sense-CurrentSense/3V3Outs/LD39200_3V3_1/EN: C11.1, C14.1, JP2.3 (B), JP4.2 (B), U2.6 (EN), U2.7 (IN), U3.6 (EN), U3.7 (IN)
/VoltageReg&Sense-CurrentSense/3V3Outs/LD39200_3V3_3/VIN: C17.1, C20.1, JP1.3 (B), JP3.2 (B), U4.7 (IN), U5.7 (IN)
/VoltageReg&Sense-CurrentSense/3V3Outs/TPS5430_BuckConv_3V3_1/EN: R7.1, R10.2, R13.1, U6.5 (EN)
/VoltageReg&Sense-CurrentSense/3V3Outs/TPS5430_BuckConv_3V3_1/VOUT: C26.1, JP2.2 (C), L3.2, R26.1
/VoltageReg&Sense-CurrentSense/3V3Outs/TPS5430_BuckConv_3V3_2/EN: R6.1, R8.2, R12.1, U7.5 (EN)
/VoltageReg&Sense-CurrentSense/3V3Outs/TPS5430_BuckConv_3V3_2/VOUT: C30.1, JP1.2 (C), L4.2, R30.1
/VoltageReg&Sense-CurrentSense/3V3Outs/VIN: C23.1, C24.1, C27.1, C28.1, C32.1, C33.1, C34.1, JP10.2 (B), R8.1, R10.1, U6.7 (VIN), U7.7 (VIN), U8.7 (VIN)
/VoltageReg&Sense-CurrentSense/5VOut/5VBuckReg/V_{OUT}: C36.1, JP5.2 (C), L6.2, R34.1
/VoltageReg&Sense-CurrentSense/5VOut/5VLD39200/EN: C37.1, JP5.3 (B), JP6.2 (B), U9.6 (EN), U9.7 (IN)
/VoltageReg&Sense-CurrentSense/5VOut/5V_{OUT}: C38.1, C39.1, JP18.1 (A), R36.1, U9.1 (OUT)
/VoltageReg&Sense-CurrentSense/CurrentMeasurement_2/V_{SENSE1}: C44.1, R45.2
/VoltageReg&Sense-CurrentSense/CurrentMeasurement_2/V_{SENSE2}: C45.1, R46.2
/VoltageReg&Sense-CurrentSense/CurrentMeasurement_3/V_{SENSE1}: C47.1, R49.2
/VoltageReg&Sense-CurrentSense/CurrentMeasurement_3/V_{SENSE2}: C48.1, R50.2
ADC_{0}: C41.1, R41.2, U1.6 (PA0)
ADC_{1}: C42.1, R42.2, U1.7 (PA1)
ADC_{6}: R2.2, R3.1, U1.12 (PA6)
ADC_{7}: R4.2, R5.1, U1.13 (PA7)
BOOT0: R1.2, U1.1 (BOOT0)
GND: C1.2, C3.2, C4.2, C6.2, C7.2, C8.2, C9.2, C10.2, C11.2, C12.2, C13.2, C14.2, C15.2, C16.2, C17.2, C18.2, C19.2, C20.2, C21.2, C22.2, C23.2, C24.2, C26.2, C27.2, C28.2, C30.2, C31.2, C32.2, C33.2, C34.2, C36.2, C37.2, C38.2, C39.2, C40.2, C41.2, C42.2, C43.2, C44.2, C45.2, C46.2, C47.2, C48.2, D1.2 (A), D2.2 (A), D3.2 (A), J1.N (NEG), J2.11 (GND), J3.4, J4.3, R5.2, R9.2, R11.2, R14.2, R16.2, R17.2, R19.2, R20.2, R22.2, R23.2, R25.2, R29.2, R33.2, R35.2, R38.2, SW2.1, SW3.1, TP3.1, U1.15 (VSS), U2.4 (GND), U2.9 (EXP), U3.4 (GND), U3.9 (EXP), U4.4 (GND), U4.9 (EXP), U5.4 (GND), U5.9 (EXP), U6.6 (GND), U7.6 (GND), U8.6 (GND), U9.4 (GND), U9.9 (EXP), U10.4 (GND), U11.4 (GND), U12.4 (GND)
NRST: C1.1, SW2.2, U1.4 (NRST)
unnamed: C25.2, D1.1 (K), L3.1, U6.8 (PH)
unnamed: C29.2, D2.1 (K), L4.1, U7.8 (PH)
unnamed: C35.2, D3.1 (K), L6.1, U8.8 (PH)
unnamed: JP1.1 (A), L1.1
unnamed: JP2.1 (A), L2.1
unnamed: C9.1, JP3.1 (A), L1.2
unnamed: C10.1, JP4.1 (A), L2.2
unnamed: JP5.1 (A), L5.1
unnamed: C31.1, JP6.1 (A), L5.2
unnamed: JP7.2 (B), R39.1, U10.5 (+IN_{2})
unnamed: JP8.2 (B), R40.1, U10.3 (+IN_{1})
unnamed: JP9.1 (A), R39.2, U10.6 (-IN_{2})
unnamed: JP10.1 (A), R40.2, U10.2 (-IN_{1})
unnamed: C40.1, JP11.1 (A), U10.8 (VDD)
unnamed: JP12.2 (B), R43.1, U11.3 (+IN_{1})
unnamed: JP13.2 (B), R44.1, U11.5 (+IN_{2})
unnamed: JP14.1 (A), R44.2, U11.6 (-IN_{2})
unnamed: JP15.1 (A), R43.2, U11.2 (-IN_{1})
unnamed: C43.1, JP16.1 (A), U11.8 (VDD)
unnamed: JP17.2 (B), R47.1, U12.3 (+IN_{1})
unnamed: JP18.2 (B), R48.1, U12.5 (+IN_{2})
unnamed: JP19.1 (A), R48.2, U12.6 (-IN_{2})
unnamed: JP20.1 (A), R47.2, U12.2 (-IN_{1})
unnamed: C46.1, JP21.1 (A), U12.8 (VDD)
unnamed: R1.1, SW3.2
unnamed: R7.2, R11.1, R13.2
unnamed: R6.2, R9.1, R12.2
unnamed: R27.2, R28.1
unnamed: R28.2, R29.1
unnamed: R31.2, R32.1
unnamed: R32.2, R33.1
unnamed: R37.2, R38.1
unnamed: R14.1, R15.2, R16.1, U2.3 (ADJ)
unnamed: R17.1, R18.2, R19.1, U3.3 (ADJ)
unnamed: R20.1, R21.2, R22.1, U4.3 (ADJ)
unnamed: R23.1, R24.2, R25.1, U5.3 (ADJ)
unnamed: C25.1, U6.1 (BOOT)
unnamed: R26.2, R27.1, U6.4 (VSENSE)
unnamed: C29.1, U7.1 (BOOT)
unnamed: R30.2, R31.1, U7.4 (VSENSE)
unnamed: C35.1, U8.1 (BOOT)
unnamed: R34.2, R35.1, U8.4 (VSENSE)
unnamed: R36.2, R37.1, U9.3 (ADJ)
unnamed: R41.1, U10.1 (OUT_{1})
unnamed: R42.1, U10.7 (OUT_{2})
unnamed: R45.1, U11.1 (OUT_{1})
unnamed: R46.1, U11.7 (OUT_{2})
unnamed: R49.1, U12.1 (OUT_{1})
unnamed: R50.1, U12.7 (OUT_{2})
SWCLK: J3.3, U1.20 (PA14)
SWDIO: J3.2, U1.19 (PA13)
VDDA: C6.1, C7.1, FB1.1, TP1.1, U1.5 (VDDA)
VS: J4.1, R2.1
VSS: J4.2, R3.2, R4.1
