XimbalEk-Electronica/CompVuelo/Communication&SensorBoard/PCB/C&SBoard.kicad_pcb

## KiCad design OldCompVuelo/Communication&SensorBoard/PCB/C&SBoard.kicad_pcb (2025-10-08, an earlier design)

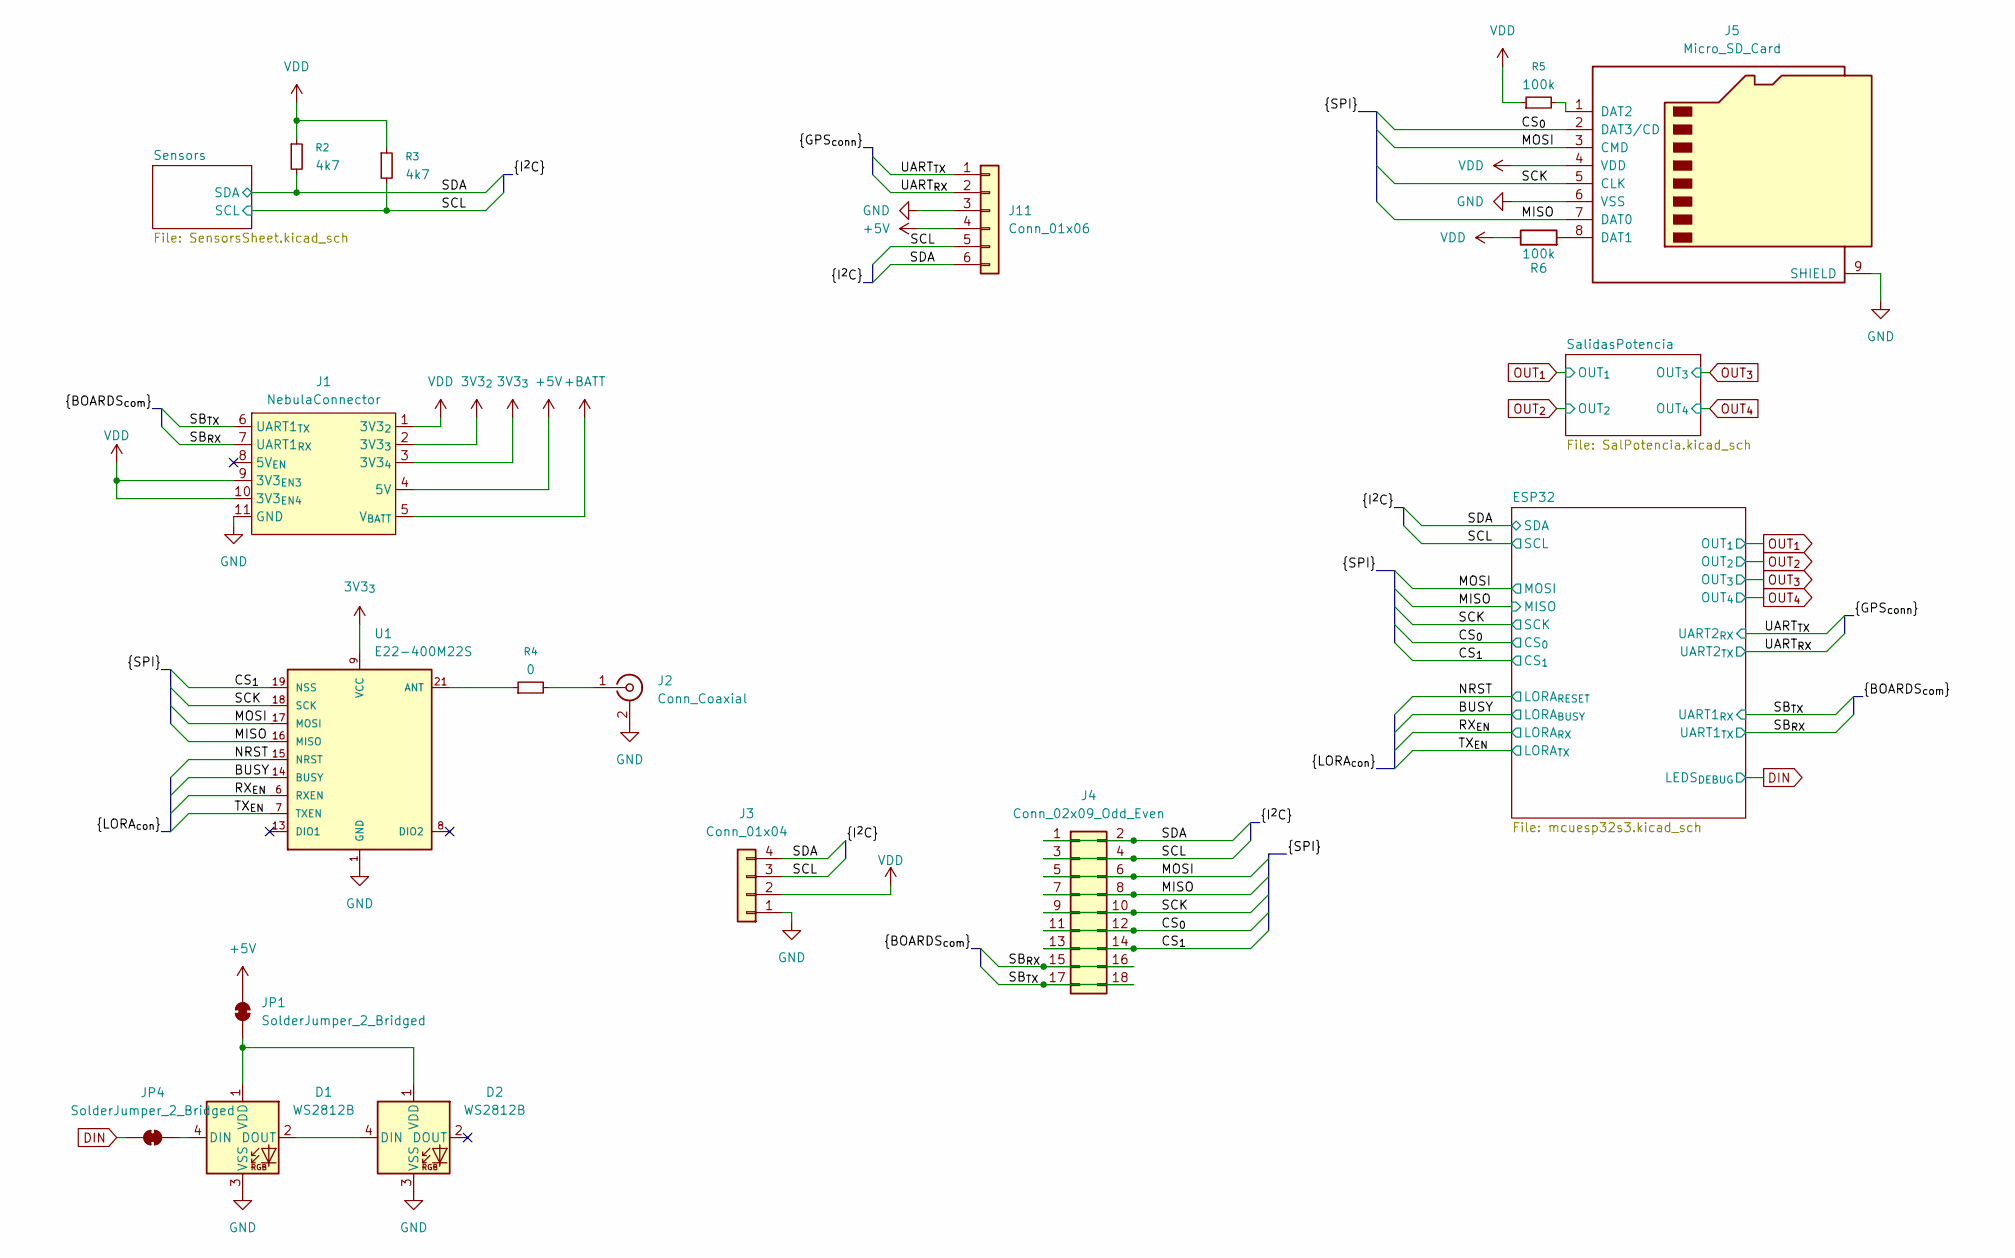
[picture p40: schematic C&SBoard.kicad_sch]

Parts:
D1, D2: WS2812B; LED_WS2812B_PLCC4_5.0x5.0mm_P3.2mm
J1: NebulaConnector; GeneralConn
J2: Conn_Coaxial; SMA_Molex_73251-2120_EdgeMount_Horizontal
J3: Conn_01x04; PinHeader_1x04_P2.54mm_Vertical
J4: Conn_02x09_Odd_Even; PinHeader_2x09_P2.54mm_Vertical
J5: Micro_SD_Card; microSD_HC_Molex_47219-2001
J11: Conn_01x06; JST_SH_BM06B-SRSS-TB_1x06-1MP_P1.00mm_Vertical
JP1, JP4: SolderJumper_2_Bridged; SolderJumper-2_P1.3mm_Bridged2Bar_RoundedPad1.0x1.5mm
R2, R3: 4k7; R_0805_2012Metric_Pad1.20x1.40mm_HandSolder
R4: 0; R_0805_2012Metric_Pad1.20x1.40mm_HandSolder
R5, R6: 100k; R_0805_2012Metric_Pad1.20x1.40mm_HandSolder
U1: E22-400M22S

Connections:
3V3_{2}: J1.2 (3V3_{3})
3V3_{3}: J1.3 (3V3_{4}), U1.9 (VCC)
+5V: J1.4 (5V), J11.4, JP1.2 (B)
+BATT: J1.5 (V_{BATT}); also elsewhere on the board
/BUSY: U1.14 (BUSY); also elsewhere on the board
/CS_{0}: J4.11, J4.12, J5.2 (DAT3/CD); also elsewhere on the board
/CS_{1}: J4.13, J4.14, U1.19 (NSS); also elsewhere on the board
/MISO: J4.7, J4.8, J5.7 (DAT0), U1.16 (MISO); also elsewhere on the board
/MOSI: J4.5, J4.6, J5.3 (CMD), U1.17 (MOSI); also elsewhere on the board
/NRST: U1.15 (NRST); also elsewhere on the board
/RX_{EN}: U1.6 (RXEN); also elsewhere on the board
/SB_{RX}: J1.7 (UART1_{RX}), J4.15, J4.16; also elsewhere on the board
/SB_{TX}: J1.6 (UART1_{TX}), J4.17, J4.18; also elsewhere on the board
/SCK: J4.9, J4.10, J5.5 (CLK), U1.18 (SCK); also elsewhere on the board
/SCL: J3.3, J4.3, J4.4, J11.5, R3.2; also elsewhere on the board
/SDA: J3.4, J4.1, J4.2, J11.6, R2.2; also elsewhere on the board
/TX_{EN}: U1.7 (TXEN); also elsewhere on the board
/UART_{RX}: J11.2; also elsewhere on the board
/UART_{TX}: J11.1; also elsewhere on the board
DIN: JP4.2 (B); also elsewhere on the board
GND: D1.3 (VSS), D2.3 (VSS), J1.11 (GND), J2.2 (Ext), J3.1, J5.6 (VSS), J5.9 (SHIELD), J11.3, U1.1 (GND); also elsewhere on the board
unnamed: D1.4 (DIN), JP4.1 (A)
unnamed: D1.2 (DOUT), D2.4 (DIN)
unnamed: D1.1 (VDD), D2.1 (VDD), JP1.1 (A)
unnamed: J2.1 (In), R4.2
unnamed: J5.8 (DAT1), R6.2
unnamed: J5.1 (DAT2), R5.2
unnamed: R4.1, U1.21 (ANT)
VDD: J1.1 (3V3_{2}), J1.9 (3V3_{EN3}), J1.10 (3V3_{EN4}), J3.2, J5.4 (VDD), R2.1, R3.1, R5.1, R6.1; also elsewhere on the board

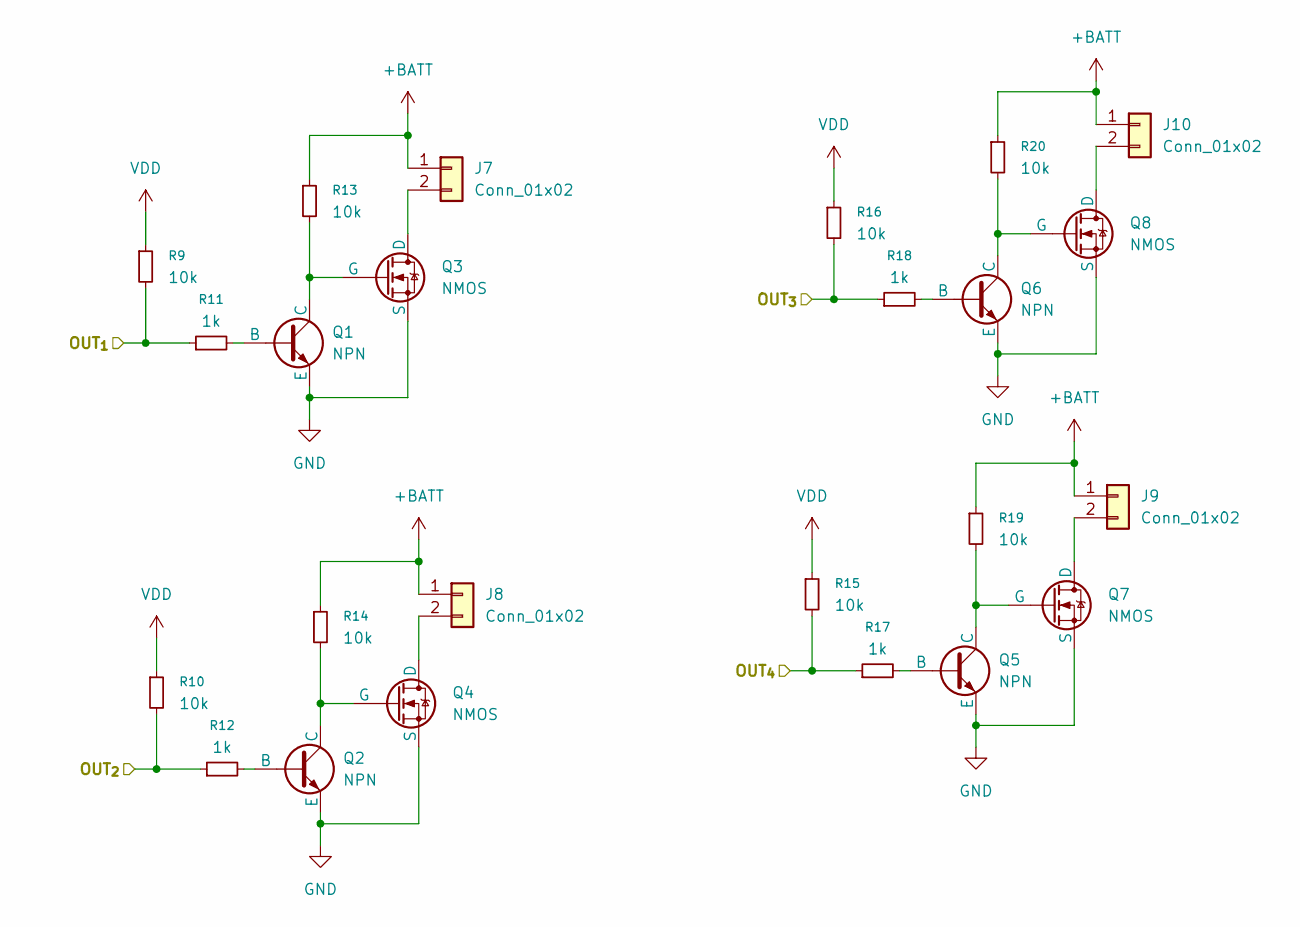
[picture p41: schematic SalPotencia.kicad_sch]

Parts:
J7, J8, J9, J10: Conn_01x02; TerminalBlock_MaiXu_MX126-5.0-02P_1x02_P5.00mm
Q1, Q2, Q5, Q6: NPN; TSOT-23
Q3, Q4, Q7, Q8: NMOS; TO-263-2
R9, R10, R13, R14, R15, R16, R19, R20: 10k; R_0805_2012Metric_Pad1.20x1.40mm_HandSolder
R11, R12, R17, R18: 1k; R_0805_2012Metric_Pad1.20x1.40mm_HandSolder

Connections:
+BATT: J7.1, J8.1, J9.1, J10.1, R13.1, R14.1, R19.1, R20.1; also elsewhere on the board
GND: Q1.3 (E), Q2.3 (E), Q3.3 (S), Q4.3 (S), Q5.3 (E), Q6.3 (E), Q7.3 (S), Q8.3 (S); also elsewhere on the board
unnamed: J7.2, Q3.2 (D)
unnamed: J8.2, Q4.2 (D)
unnamed: J9.2, Q7.2 (D)
unnamed: J10.2, Q8.2 (D)
unnamed: Q1.2 (B), R11.2
unnamed: Q1.1 (C), Q3.1 (G), R13.2
unnamed: Q2.2 (B), R12.2
unnamed: Q2.1 (C), Q4.1 (G), R14.2
unnamed: Q5.2 (B), R17.2
unnamed: Q5.1 (C), Q7.1 (G), R19.2
unnamed: Q6.2 (B), R18.2
unnamed: Q6.1 (C), Q8.1 (G), R20.2
OUT_{1}: R9.2, R11.1; also elsewhere on the board
OUT_{2}: R10.2, R12.1; also elsewhere on the board
OUT_{3}: R16.2, R18.1; also elsewhere on the board
OUT_{4}: R15.2, R17.1; also elsewhere on the board
VDD: R9.1, R10.1, R15.1, R16.1; also elsewhere on the board

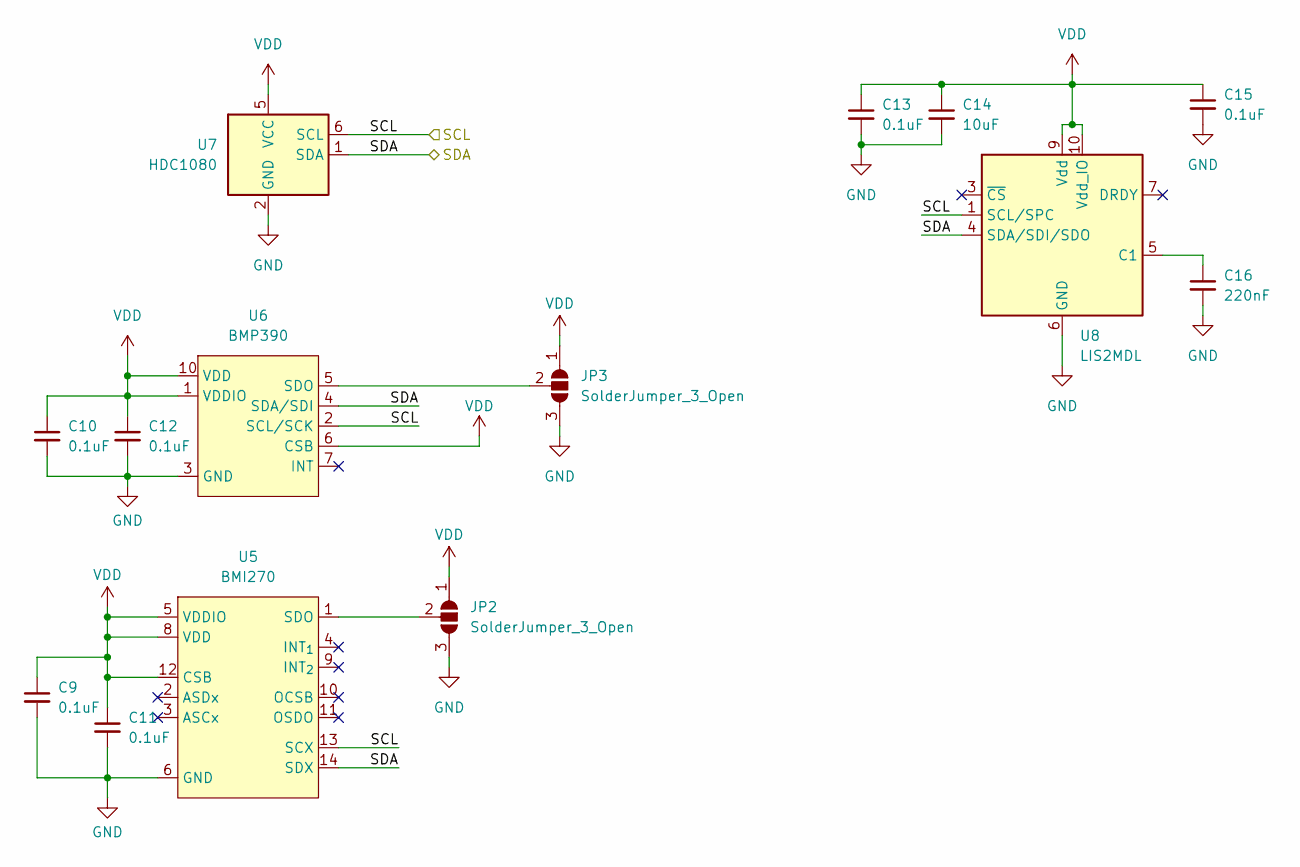
[picture p42: schematic SensorsSheet.kicad_sch]

Parts:
C9, C10, C11, C12, C13, C15: 0.1uF; C_0805_2012Metric_Pad1.18x1.45mm_HandSolder
C14: 10uF; C_0805_2012Metric_Pad1.18x1.45mm_HandSolder
C16: 220nF; C_0805_2012Metric_Pad1.18x1.45mm_HandSolder
JP2, JP3: SolderJumper_3_Open; SolderJumper-3_P1.3mm_Open_RoundedPad1.0x1.5mm
U5: BMI270; XDCR_BMI270
U6: BMP390; XDCR_BMP390L
U7: HDC1080; Texas_PWSON-N6
U8: LIS2MDL; LGA-12_2x2mm_P0.5mm

Connections:
/SCL: U5.13 (SCX), U6.2 (SCL/SCK), U7.6 (SCL), U8.1 (SCL/SPC); also elsewhere on the board
/SDA: U5.14 (SDX), U6.4 (SDA/SDI), U7.1 (SDA), U8.4 (SDA/SDI/SDO); also elsewhere on the board
GND: C9.2, C10.2, C11.2, C12.2, C13.2, C14.2, C15.2, C16.2, JP2.3 (B), JP3.3 (B), U5.6 (GND), U6.3 (GND), U7.2 (GND), U8.6 (GND), U8.8 (GND); also elsewhere on the board
unnamed: JP2.2 (C), U5.1 (SDO)
unnamed: JP3.2 (C), U6.5 (SDO)
unnamed: C16.1, U8.5 (C1)
VDD: C9.1, C10.1, C11.1, C12.1, C13.1, C14.1, C15.1, JP2.1 (A), JP3.1 (A), U5.5 (VDDIO), U5.8 (VDD), U5.12 (CSB), U6.1 (VDDIO), U6.6 (CSB), U6.10 (VDD), U7.5 (VCC), U8.9 (Vdd), U8.10 (Vdd_IO); also elsewhere on the board

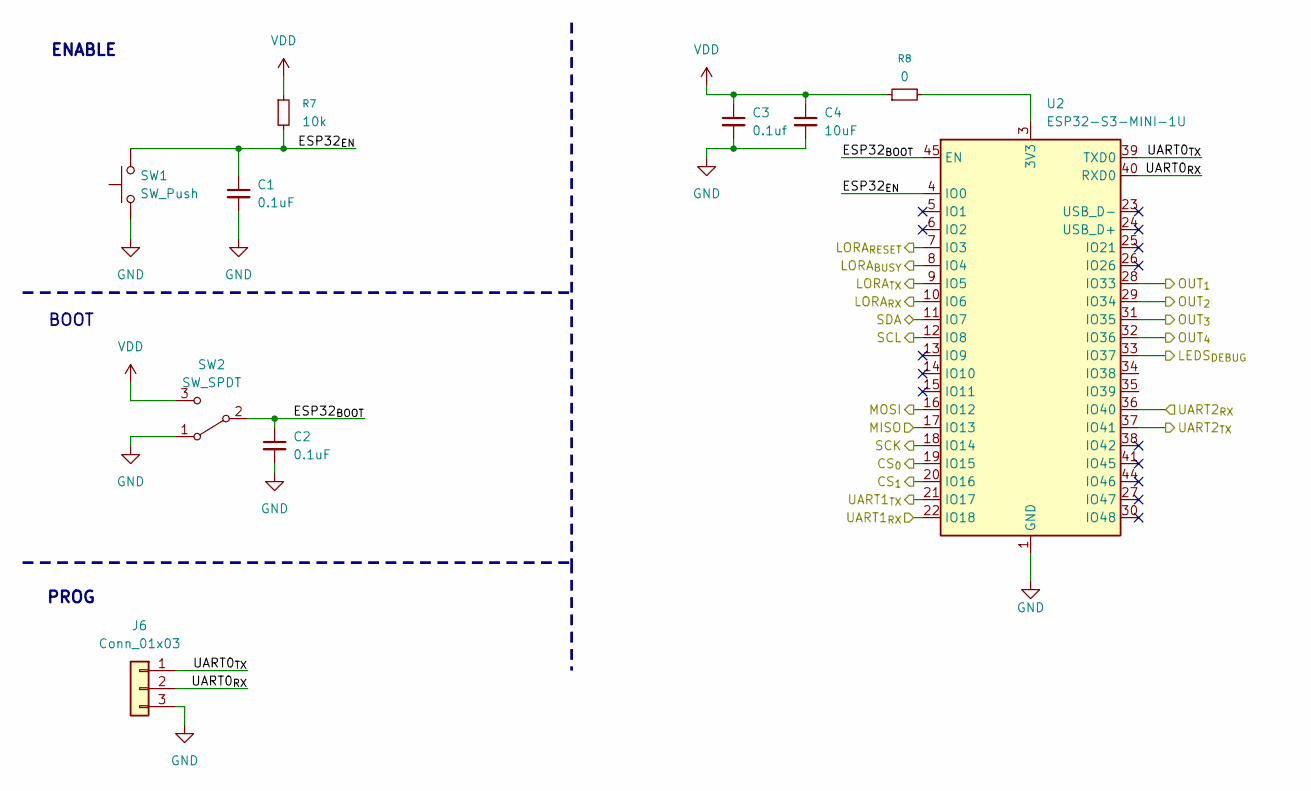
[picture p43: schematic mcuesp32s3.kicad_sch]

Parts:
C1, C2: 0.1uF; C_0805_2012Metric_Pad1.18x1.45mm_HandSolder
C3: 0.1uf; C_0805_2012Metric_Pad1.18x1.45mm_HandSolder
C4: 10uF; C_0805_2012Metric_Pad1.18x1.45mm_HandSolder
J6: Conn_01x03; PinHeader_1x03_P2.54mm_Vertical
R7: 10k; R_0805_2012Metric_Pad1.20x1.40mm_HandSolder
R8: 0; R_0805_2012Metric_Pad1.20x1.40mm_HandSolder
SW1: SW_Push
SW2: SW_SPDT; SW_SPDT_Shouhan_MSK12C02
U2: ESP32-S3-MINI-1U; ESP32-S2-MINI-1U

Connections:
/BUSY: U2.8 (IO4); also elsewhere on the board
/CS_{0}: U2.19 (IO15); also elsewhere on the board
/CS_{1}: U2.20 (IO16); also elsewhere on the board
/ESP32/ESP32_{BOOT}: C2.1, SW2.2, U2.45 (EN)
/ESP32/ESP32_{EN}: C1.1, R7.2, SW1.2, U2.4 (IO0)
/ESP32/UART0_{RX}: J6.2, U2.40 (RXD0)
/ESP32/UART0_{TX}: J6.1, U2.39 (TXD0)
/MISO: U2.17 (IO13); also elsewhere on the board
/MOSI: U2.16 (IO12); also elsewhere on the board
/NRST: U2.7 (IO3); also elsewhere on the board
/RX_{EN}: U2.10 (IO6); also elsewhere on the board
/SB_{RX}: U2.21 (IO17); also elsewhere on the board
/SB_{TX}: U2.22 (IO18); also elsewhere on the board
/SCK: U2.18 (IO14); also elsewhere on the board
/SCL: U2.12 (IO8); also elsewhere on the board
/SDA: U2.11 (IO7); also elsewhere on the board
/TX_{EN}: U2.9 (IO5); also elsewhere on the board
/UART_{RX}: U2.37 (IO41); also elsewhere on the board
/UART_{TX}: U2.36 (IO40); also elsewhere on the board
DIN: U2.33 (IO37); also elsewhere on the board
GND: C1.2, C2.2, C3.2, C4.2, J6.3, SW1.1, SW2.1, U2.1 (GND), U2.2 (GND), U2.42 (GND), U2.43 (GND), U2.46 (GND), U2.47 (GND), U2.48 (GND), U2.49 (GND), U2.50 (GND), U2.51 (GND), U2.52 (GND), U2.53 (GND), U2.54 (GND), U2.55 (GND), U2.56 (GND), U2.57 (GND), U2.58 (GND), U2.59 (GND), U2.60 (GND), U2.61 (GND), U2.62 (GND), U2.63 (GND), U2.64 (GND), U2.65 (GND); also elsewhere on the board
unnamed: R8.2, U2.3 (3V3)
OUT_{1}: U2.28 (IO33); also elsewhere on the board
OUT_{2}: U2.29 (IO34); also elsewhere on the board
OUT_{3}: U2.31 (IO35); also elsewhere on the board
OUT_{4}: U2.32 (IO36); also elsewhere on the board
VDD: C3.1, C4.1, R7.1, R8.1, SW2.3; also elsewhere on the board

Notes on the sheet:
ENABLE
BOOT
PROG

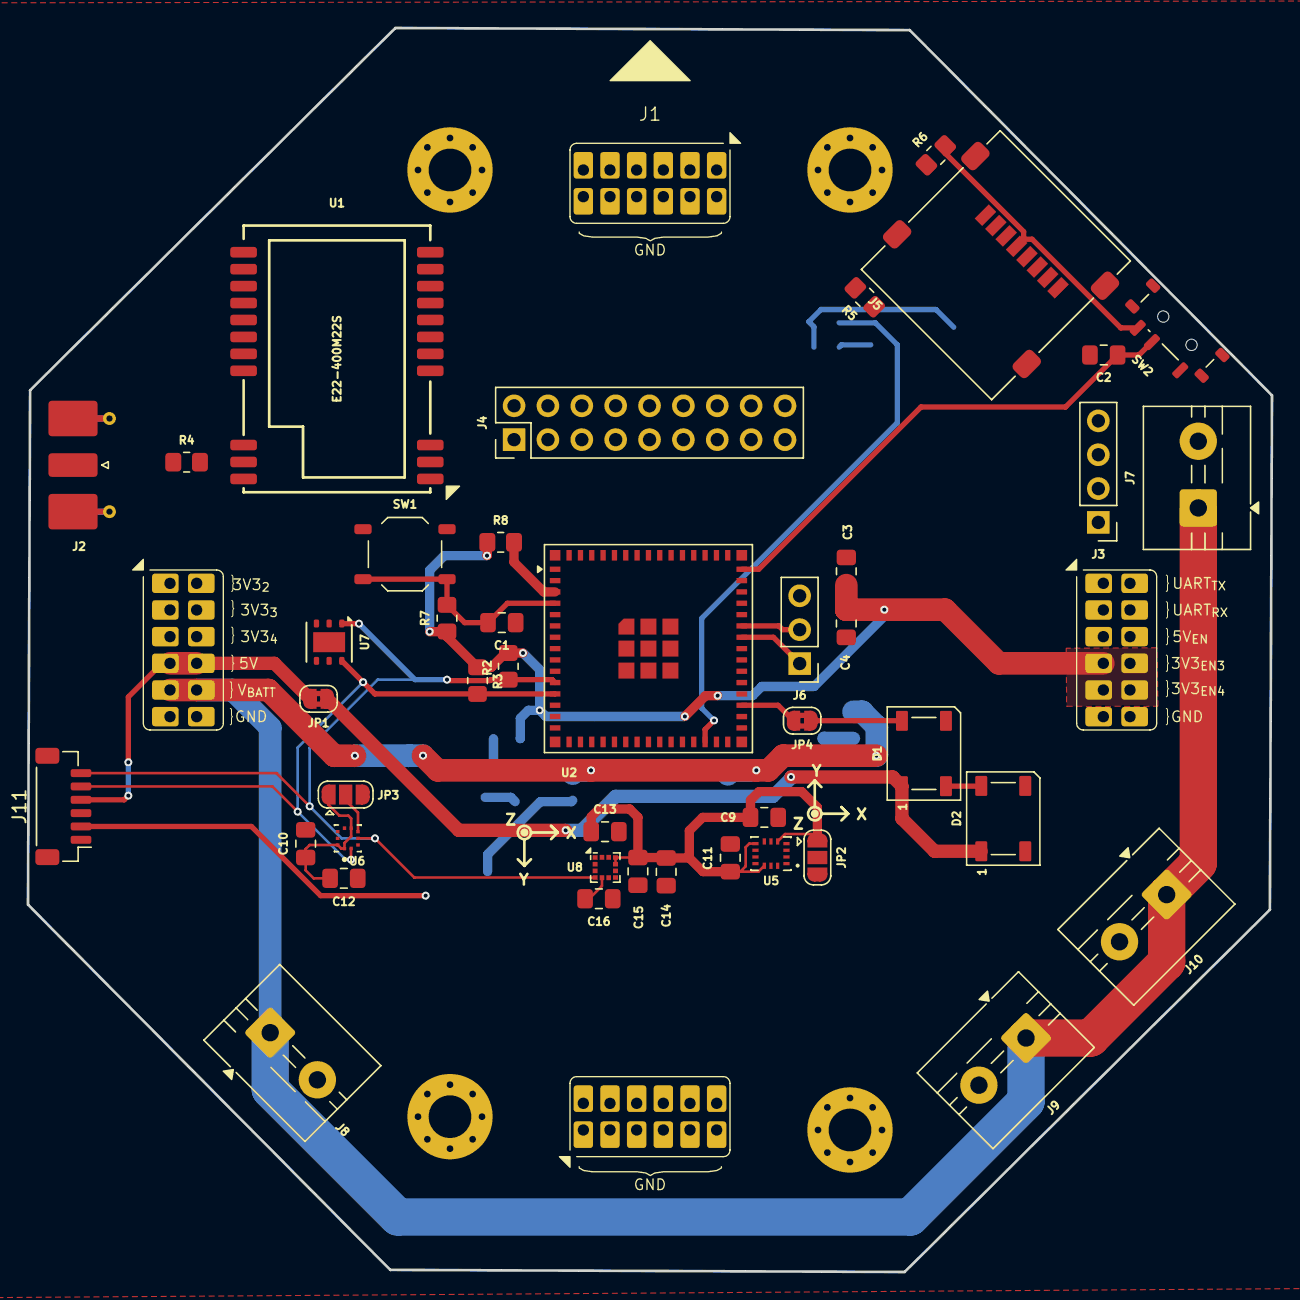
[picture p44: board C&SBoard.kicad_pcb from above]

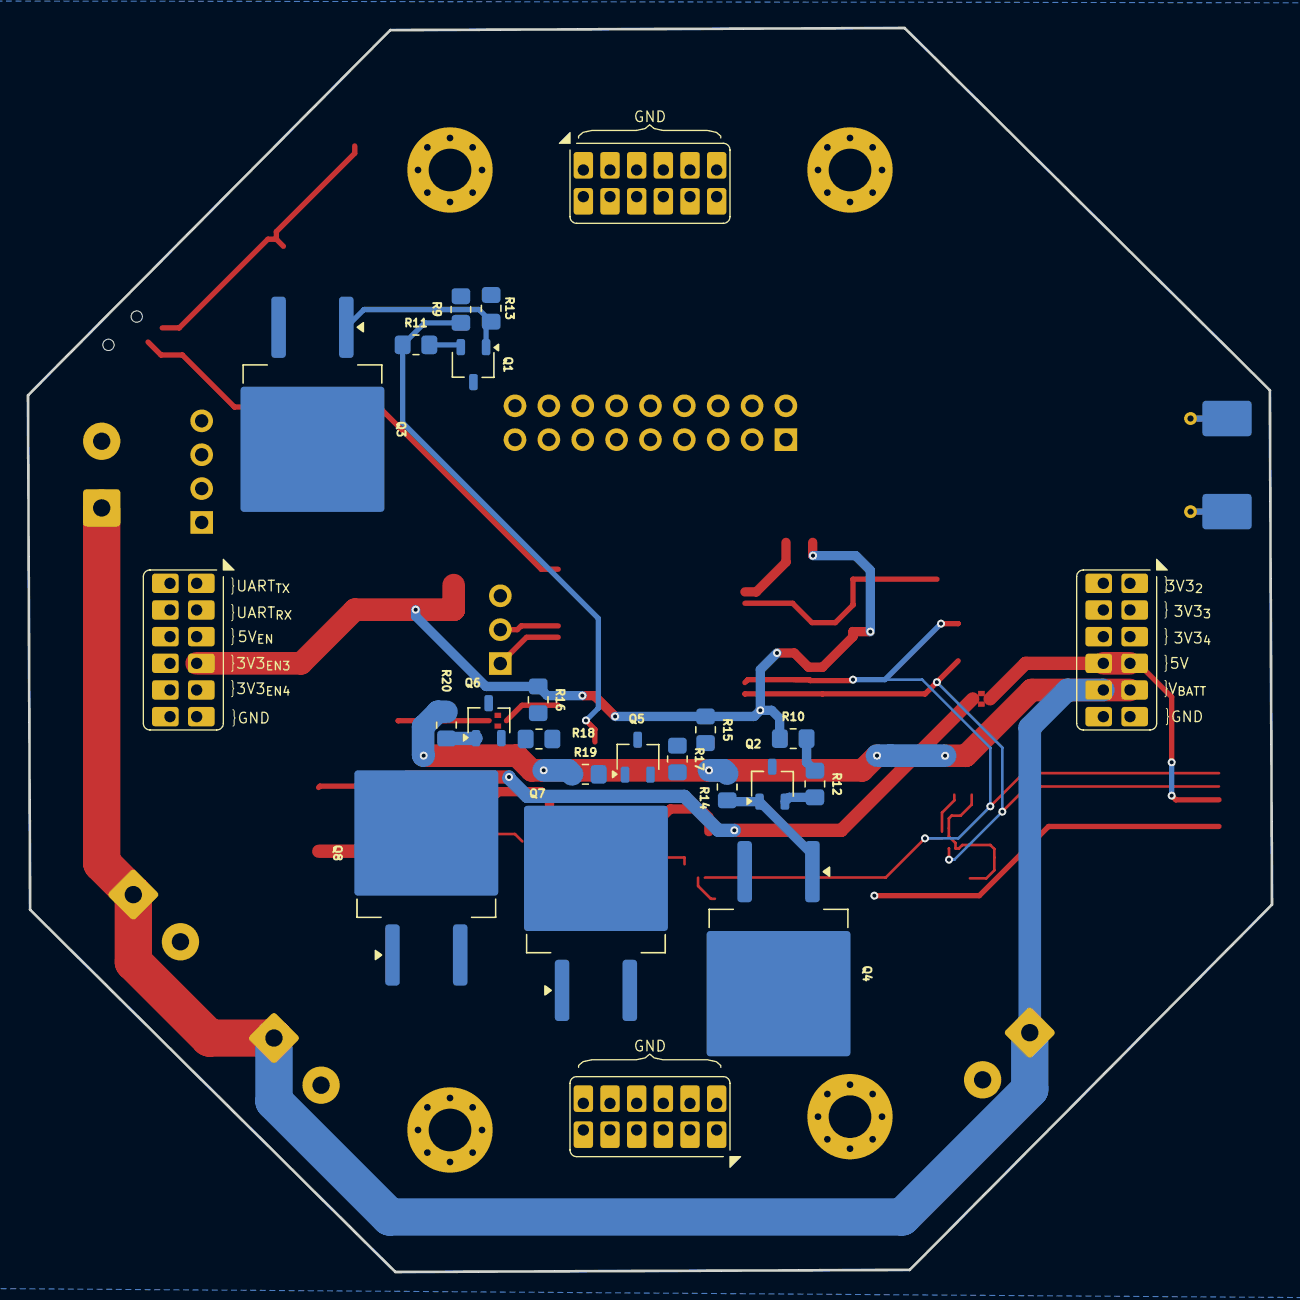
[picture p45: board C&SBoard.kicad_pcb from below]

Board: 2 copper layers, 93.3 x 93.3 mm, 64 parts (20 on the bottom side), 52 nets.
