XimbalEk-Electronica/CompVuelo/(commit log)

2025-08-24 añadir archivos kicad
    [CompVueloPotencia.kicad_pcb, CompVueloPotencia.kicad_sch]
2025-08-24 test for updates
    [CompVueloPotencia.kicad_sch]
2025-08-24 another test of updates
    [CompVueloPotencia.kicad_sch]
2025-08-24 last test for updates, only add to gitignore the prl file
    [CompVueloPotencia.kicad_sch]
2025-08-25 little changes
    [CompVueloPotencia.kicad_sch]
2025-08-25 del kicad_prl
2025-08-26 test from windows
    [CompVueloPotencia.kicad_sch]
2025-08-28 made the buck converter schematic & MCU selection
    [BuckConv.kicad_sch, CompVueloPotencia.kicad_sch, McuStm32.kicad_sch]
2025-09-02 uptade de schematic
    [CompVueloPotencia.kicad_sch, McuStm32.kicad_sch]
2025-09-05 Actualizacion de esquematicos de fuente tipo Buck
    [BuckConv.kicad_sch, BuckConv3v3.kicad_sch, CompVueloPotencia.kicad_sch]
2025-09-09 Semi finished the regulator-section
    [3v3Outs.kicad_sch, BuckConv.kicad_sch, BuckConv3v3.kicad_sch, CompVueloPotencia.kicad_pcb, CompVueloPotencia.kicad_sch, McuStm32.kicad_sch, ld39200_3v3.kicad_sch]
2025-09-09 update de distrubution
    [3v3Outs.kicad_sch, BuckConv.kicad_sch, BuckConv3v3.kicad_sch, CompVueloPotencia.kicad_pcb, CompVueloPotencia.kicad_sch, McuStm32.kicad_sch, ld39200_3v3.kicad_sch]
2025-09-10 Mcu Finishes, i think
    [3v3Outs.kicad_sch, BuckConv.kicad_sch, BuckConv3v3.kicad_sch, CompVueloPotencia.kicad_pcb, CompVueloPotencia.kicad_sch, McuStm32.kicad_sch, ld39200_3v3.kicad_sch]
2025-09-12 Reorganize the folders in the project
    [3v3Outs.kicad_sch, BuckConv.kicad_sch, BuckConv3v3.kicad_sch, CompVueloPotencia.kicad_pcb, CompVueloPotencia.kicad_sch, HTSOP-J8.STEP, LD39200DPUR.step, McuStm32.kicad_sch]
2025-09-19 Supply Board - Remake Schematic in KiCad 9
    [5Vregulator.kicad_sch, BuckConv.kicad_sch, BuckConv3v3.kicad_sch, CompVueloPotencia.kicad_pcb, CompVueloPotencia.kicad_sch, Current1_2.kicad_sch, Current_3_4.kicad_sch, HTSOP-J8.STEP]
2025-09-19 organize the folders
    [5Vregulator.kicad_sch, BuckConv3v3.kicad_sch, Current1_2.kicad_sch, Current_3_4.kicad_sch, SupplyBoardCompVuelo.kicad_pcb, SupplyBoardCompVuelo.kicad_sch, VoltageReg.kicad_sch, ld39200_3v3.kicad_sch]
2025-09-19 Supply board - Update the current measurement
    [Current1_2.kicad_sch, Current_1_2.kicad_sch, SupplyBoardCompVuelo.kicad_sch, stmmcu.kicad_sch]
2025-09-19 supply board - delete backups
2025-09-22 SupplyBoard - finish current sense
    Finish the Current Sensor Circuit and add more 3.3V out, i change de microcontroles to a mcu that have the exact GPIO's
    [5VBuckReg.kicad_sch, 5Vregulator.kicad_sch, 5vLDO.kicad_sch, BuckConv3v3.kicad_sch, CurrentSense5-6.kicad_sch, Current_3_4.kicad_sch, Reg_Sense.kicad_sch, SupplyBoardCompVuelo.kicad_sch]
2025-09-22 Stop track backupfiles
2025-09-23 SupplyBoard - update layout
    schematic completed and PCB layout started; only the routing of the traces remains to be done
    [12-Pin Header - Female - Double - 2.54mm.step, 5VBuckReg.kicad_sch, 5Vregulator.kicad_sch, 5vLDO.kicad_sch, BuckConv3v3.kicad_sch, Current_1_2.kicad_sch, Current_3_4.kicad_sch, L-KLS7-SS-12F20A-G5.step]
2025-09-25 Supply Board & Folder Organization
    Reorganization of the power supply board components, simplifying the layout to facilitate future debugging and reorganizing some folders and documents, as well as adding the power supply board schematic; in supply board only need to make the routing
    [12-Pin Header - Female - Double - 2.54mm.step, 5VBuckReg.kicad_sch, 5Vregulator.kicad_sch, 5vLDO.kicad_sch, BuckConv3v3.kicad_sch, C&SBoard.kicad_pcb, C&SBoard.kicad_sch, CurrentSense5-6.kicad_sch]
2025-09-26 Start the S&CBoard
    [BMI270.step, BMP390L.step, C&SBoard.kicad_sch, stmmcu.kicad_sch]
2025-10-03 Supply & Coms-Sensor Board
    la organizacion de los componentes presentes en las placas, se quedaran de esa manera, se espera que en la serigrafia se incluyan los logos de los patrocinadores, ademas se incluyo la carpeta 3D la cual contiene modelos en 3D de las dos placas, con serigrafia y componentes incluidos y ya
    [0472192001.stp, C&SBoard.kicad_pcb, C&SBoard.kicad_sch, E22-400M22S.STEP, E22400M22S.kicad_sch, ESP32-S3-MINI-1U-N8--3DModel-STEP-56544.STEP, LCC-18_9P7X10P1_STM.step, LIS2MDLTR.step]
2025-10-07 C&S board - update GPS
    se cambio el conector del gps pasando de un sistema incorporado en placa a un sistema externo, con el BZ251
    [C&SBoard.kicad_pcb, C&SBoard.kicad_sch, mcuesp32s3.kicad_sch]
2025-10-08 C&S-board
    se avanzo en el trazado de pistas
    [C&SBoard.kicad_pcb]
2025-12-03 start a new version of the flight computer
    [0472192001.stp, 12-Pin Header - Female - Double - 2.54mm.step, 5VBuckReg.kicad_sch, 5Vregulator.kicad_sch, 5vLDO.kicad_sch, BMI270.step, BMP390L.step, BuckConv3v3.kicad_sch]
2025-12-05 little changesss
    [CompVuelo_V2.0.kicad_sch, mcustm32.kicad_sch]
2026-01-22 prueba0
    mostrar avance
    [CompVuelo_V2.0.kicad_pcb, CompVuelo_V2.0.kicad_sch, mcuesp32.kicad_sch, mcustm32.kicad_sch]
